S2A-Lab/CAD-Binder-Jetting-3D-Printer/X Axis/Encoder Rail/A_XA_ER.SLDASM

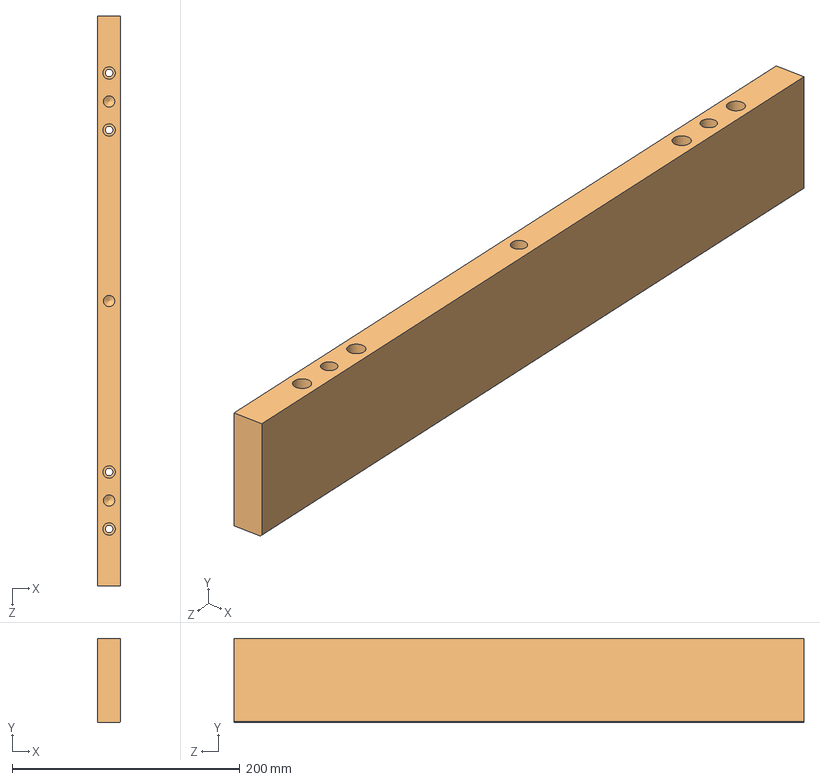
[picture p1: CAD file, 2025-05-02]
X Axis/Encoder Rail/A_XA_ER.SLDASM
20.2 x 74.0 x 500.0 mm
PE_XA_ER_BF003_scale_block
PE_XA_ER_encoder_strip-A_9420_0048
