S2A-Lab/CAD-Binder-Jetting-3D-Printer/Gantry/Hopper/SG4L TM.SLDASM

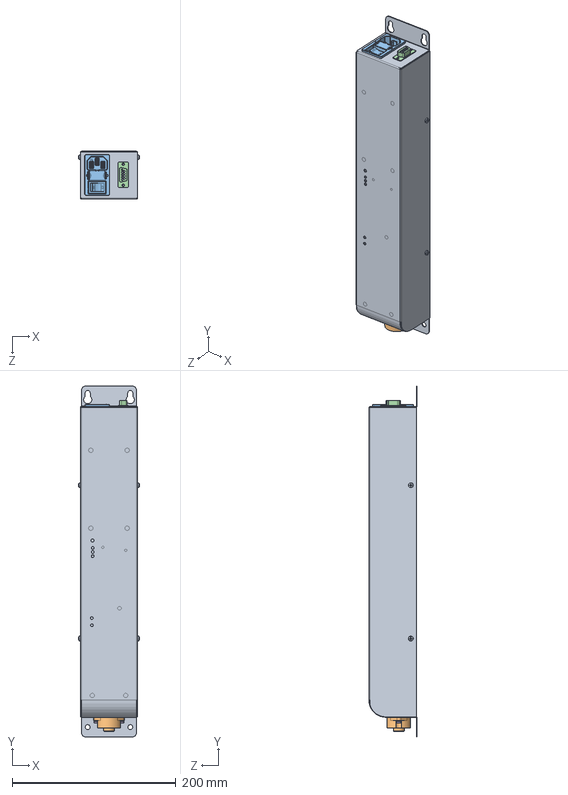
[picture p2: CAD file, 2025-05-02]
Gantry/Hopper/SG4L TM.SLDASM
74.7 x 429.0 x 59.0 mm
888016919_01^SG4L TM(2)_SG4L TM
370843000^SG4L TM(2)_SG4L TM
350200000_01^SG4L TM(2)_SG4L TM
371806910^SG4L TM(2)_SG4L TM
Federring rostfrei_M 3^SG4L TM(2)_SG4L TM x 2
Linsenschr. rostf. TORX_M3 x 8^SG4L TM(2)_SG4L TM x 2
