S2A-Lab/CAD-Binder-Jetting-3D-Printer/Gantry/Recoating System/Fine Roller/pcb/printedcircuit.SLDASM

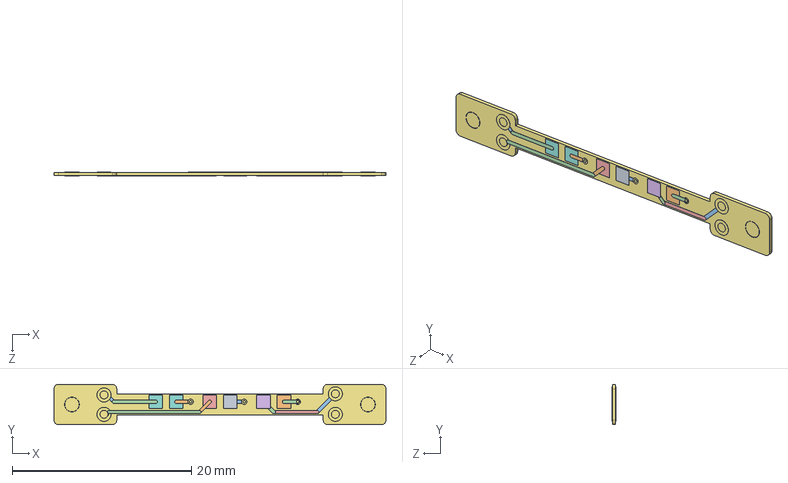
[picture p3: CAD file, 2025-05-02]
Gantry/Recoating System/Fine Roller/pcb/printedcircuit.SLDASM
37.0 x 4.50 x 0.391 mm
Via Hole-Part-1 x 2
Track (220mil,520mil)(232.718mil,520mil) on Top Layer-Part-1
Track (232.718mil,520mil)(262.718mil,490mil) on Top Layer-Part-1
Track (262.718mil,490mil)(447.402mil,490mil) on Top Layer-Part-1
Via Hole-Part-1-1 x 4
Via Bottom Layer-Part-1 x 4
Via Top Layer-Part-1 x 4
Pad Fs3-0(447.402mil,490mil) on Top Layer-Part-1
Track (220mil,435mil)(232.718mil,435mil) on Top Layer-Part-1
Track (638.602mil,445mil)(683.602mil,490mil) on Top Layer-Part-1
Track (232.718mil,435mil)(242.718mil,445mil) on Top Layer-Part-1
Track (242.718mil,445mil)(638.602mil,445mil) on Top Layer-Part-1
Pad Fs2-0(683.602mil,490mil) on Top Layer-Part-1
Track (600mil,490mil)(835mil,490mil) on Bottom Layer-Part-1
Track (835mil,490mil)(1070mil,490mil) on Bottom Layer-Part-1
Track (1180mil,490mil)(1235mil,435mil) on Bottom Layer-Part-1
Track (1070mil,490mil)(1180mil,490mil) on Bottom Layer-Part-1
Track (537.402mil,490mil)(600mil,490mil) on Top Layer-Part-1
Track (773.602mil,490mil)(835mil,490mil) on Top Layer-Part-1
Track (1009.842mil,490mil)(1070mil,490mil) on Top Layer-Part-1
Via Hole-Part-1-2 x 3
Via Bottom Layer-Part-1-1 x 3
Via Top Layer-Part-1-1 x 3
Pad Fs3-1(537.402mil,490mil) on Top Layer-Part-1
Pad Fs2-1(773.602mil,490mil) on Top Layer-Part-1
Pad Fs1-1(1009.842mil,490mil) on Top Layer-Part-1
Track (1155mil,445mil)(1235mil,525mil) on Top Layer-Part-1
Track (919.842mil,490mil)(964.842mil,445mil) on Top Layer-Part-1
Track (964.842mil,445mil)(1155mil,445mil) on Top Layer-Part-1
Pad Fs1-0(919.842mil,490mil) on Top Layer-Part-1
Board-Part-1
