S2A-Lab/CAD-Binder-Jetting-3D-Printer/Gantry/Recoating System/Fine Roller/pcb/Board.sldasm

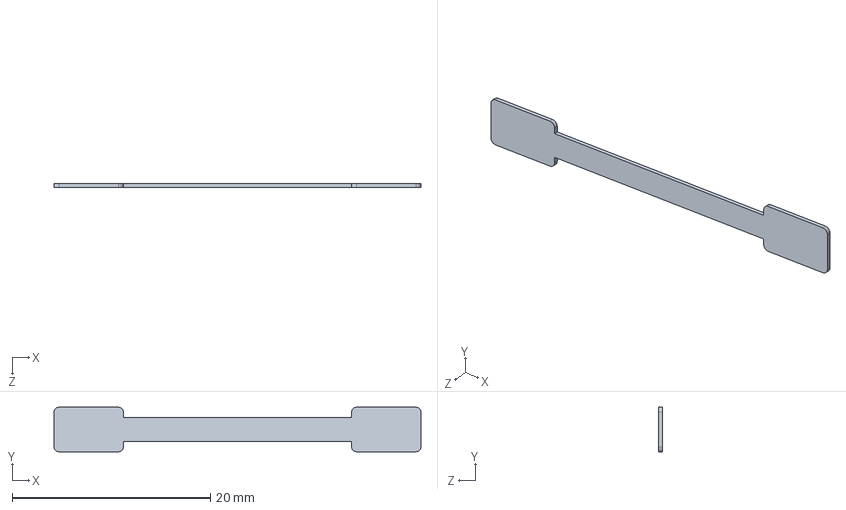
[picture p4: CAD file, 2025-05-02]
Gantry/Recoating System/Fine Roller/pcb/Board.sldasm
37.0 x 4.50 x 0.371 mm
