S2A-Lab/CAD-Binder-Jetting-3D-Printer/Gantry/Hopper/PE_G_H_SK3510 Hummel 90.SLDPRT

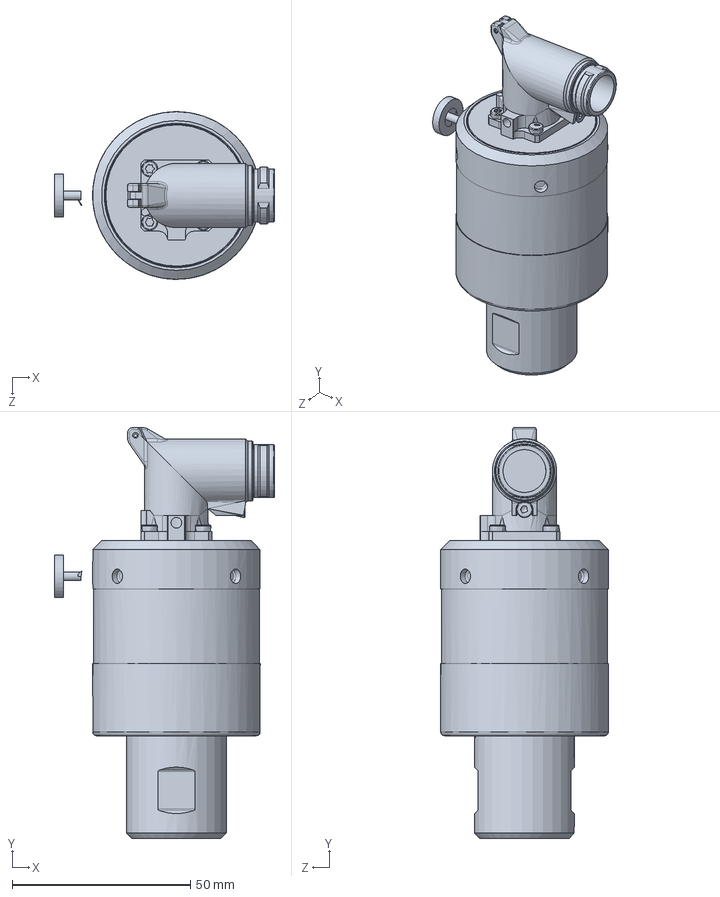
[picture p5: CAD file, 2025-05-02]
Gantry/Hopper/PE_G_H_SK3510 Hummel 90.SLDPRT
61.7 x 115.2 x 47.0 mm
