S2A-Lab/CAD-Binder-Jetting-3D-Printer/Gantry/P_G_C.SLDPRT

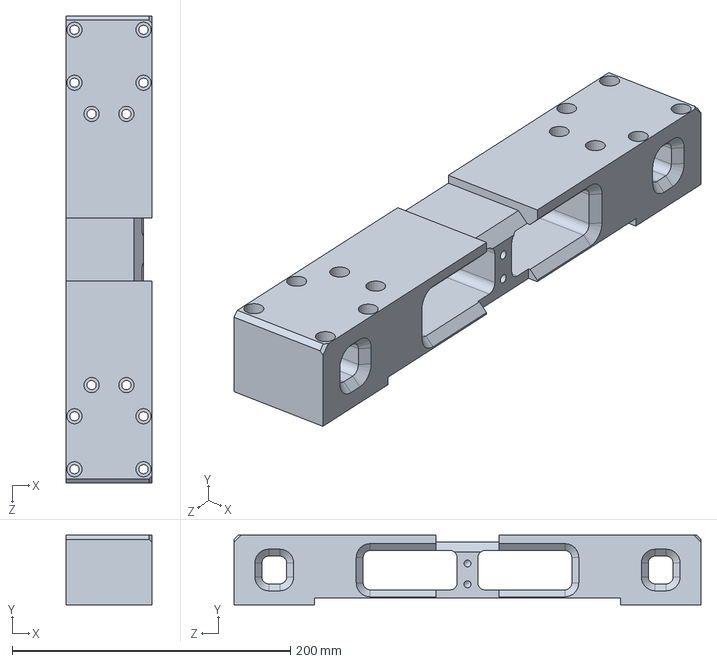
[picture p6: CAD file, 2025-05-02]
Gantry/P_G_C.SLDPRT
61.7 x 50.0 x 335.8 mm
