S2A-Lab/CAD-Binder-Jetting-3D-Printer/Gantry/Print Head Motion System/PE_G_PHM_HSB.SLDPRT

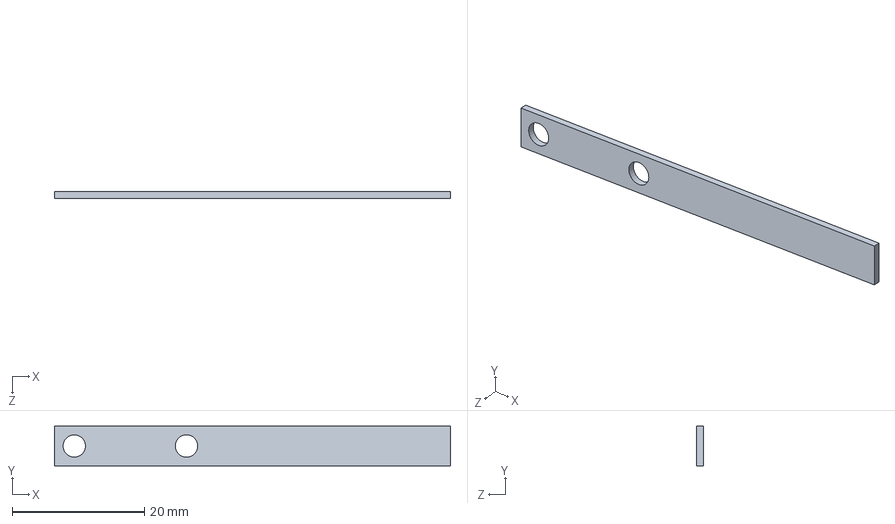
[picture p7: CAD file, 2025-05-02]
Gantry/Print Head Motion System/PE_G_PHM_HSB.SLDPRT
60.0 x 6.00 x 1.00 mm
