S2A-Lab/CAD-Binder-Jetting-3D-Printer/Gantry/Recoating System/Fine Roller/force_measuring_roller.beam_mount.SLDPRT

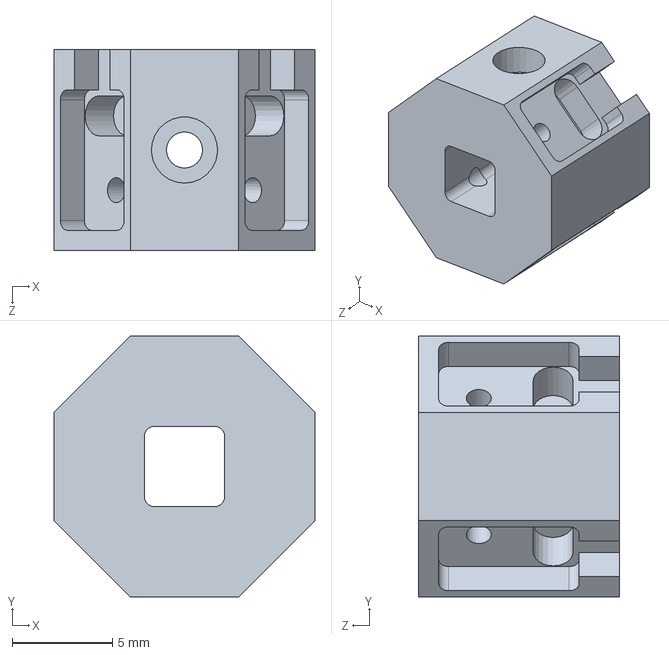
[picture p8: CAD file, 2025-05-02]
Gantry/Recoating System/Fine Roller/force_measuring_roller.beam_mount.SLDPRT
13.0 x 13.0 x 10.0 mm
