S2A-Lab/CAD-Binder-Jetting-3D-Printer/Gantry/Recoating System/Fine Roller/pcb.force_sensor/pcb_layout.SLDPRT

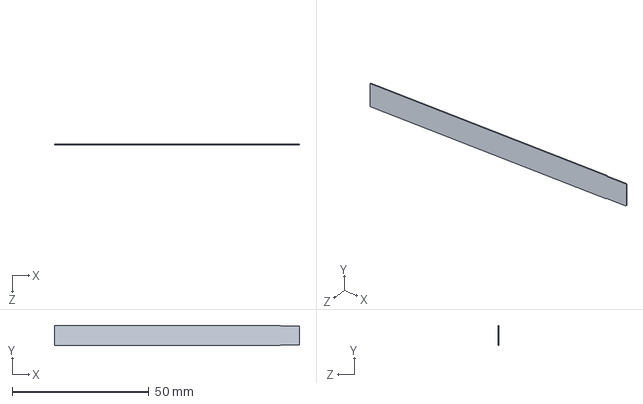
[picture p9: CAD file, 2025-05-02]
Gantry/Recoating System/Fine Roller/pcb.force_sensor/pcb_layout.SLDPRT
89.5 x 7.33 x 0.3 mm
