S2A-Lab/CAD-Binder-Jetting-3D-Printer/Gantry/Recoating System/PE_P_G_R_CR_6661K14_Ball Bearing.SLDPRT

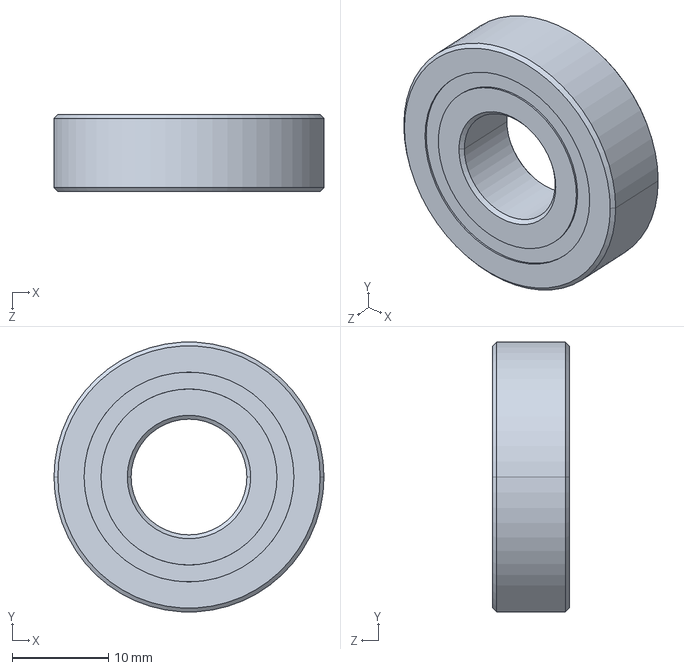
[picture p10: CAD file, 2025-05-02]
Gantry/Recoating System/PE_P_G_R_CR_6661K14_Ball Bearing.SLDPRT
28.0 x 28.0 x 8.00 mm
