S2A-Lab/CAD-Binder-Jetting-3D-Printer/PE_HFSH8-8080-500.sldprt

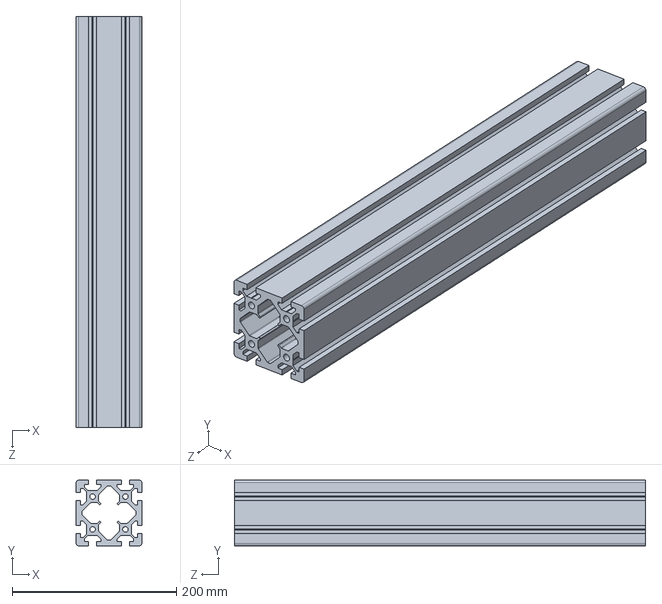
[picture p11: CAD file, 2025-05-02]
PE_HFSH8-8080-500.sldprt
80.0 x 80.0 x 500.0 mm
