S2A-Lab/CAD-Binder-Jetting-3D-Printer/Vent Hood/P_VH_HA_F.SLDPRT

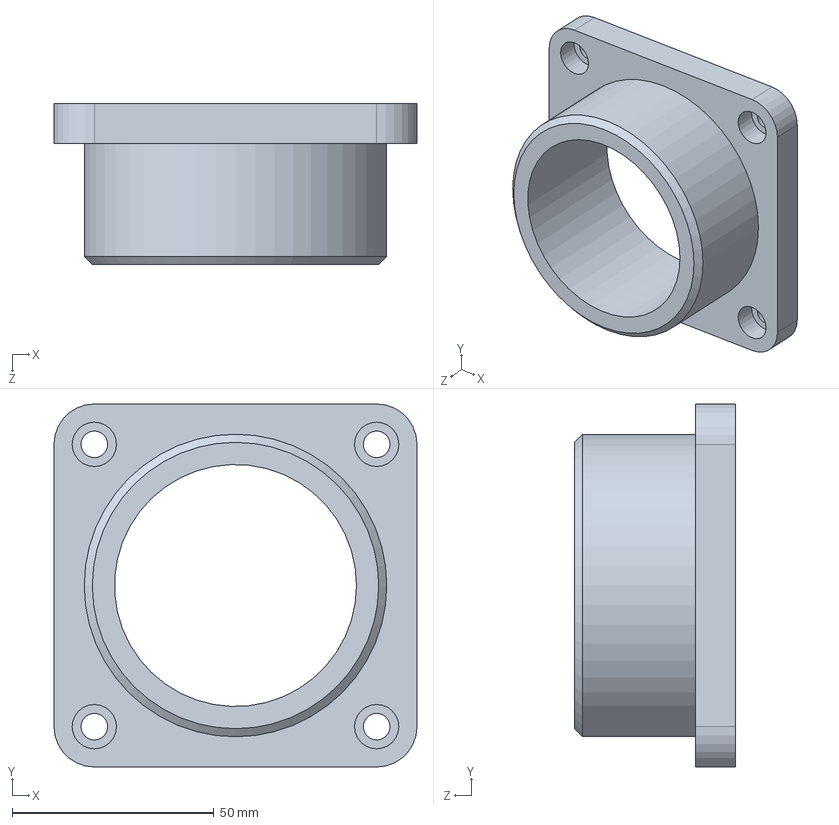
[picture p12: CAD file, 2025-05-02]
Vent Hood/P_VH_HA_F.SLDPRT
90.0 x 90.0 x 40.0 mm
