S2A-Lab/CAD-Binder-Jetting-3D-Printer/Gantry/Hopper/P_G_H_MT.SLDPRT

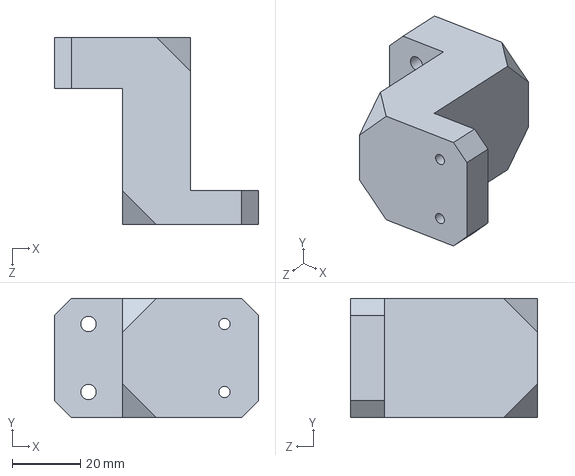
[picture p13: CAD file, 2025-05-02]
Gantry/Hopper/P_G_H_MT.SLDPRT
60.0 x 35.0 x 55.0 mm
