S2A-Lab/CAD-Binder-Jetting-3D-Printer/Gantry/P_G_F.SLDPRT

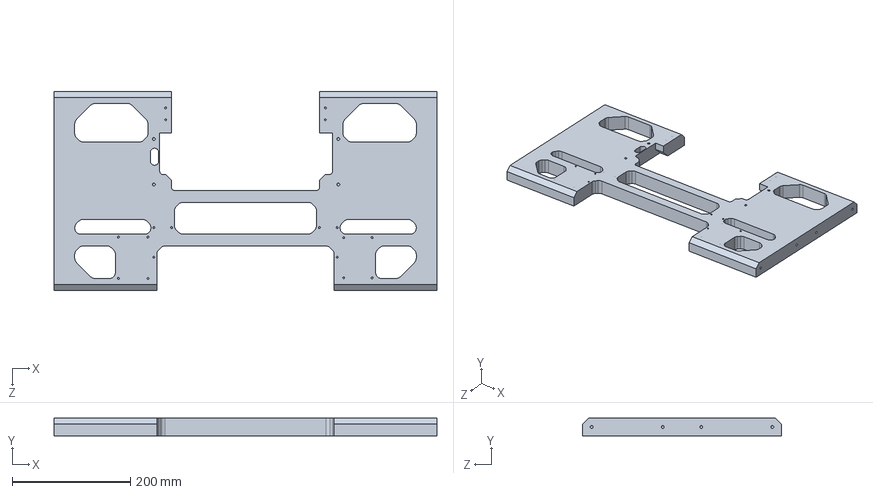
[picture p14: CAD file, 2025-05-02]
Gantry/P_G_F.SLDPRT
647.6 x 30.0 x 335.8 mm
