S2A-Lab/CAD-Binder-Jetting-3D-Printer/Gantry/Print Head Motion System/PE_G_PHM_AEB_A.SLDPRT

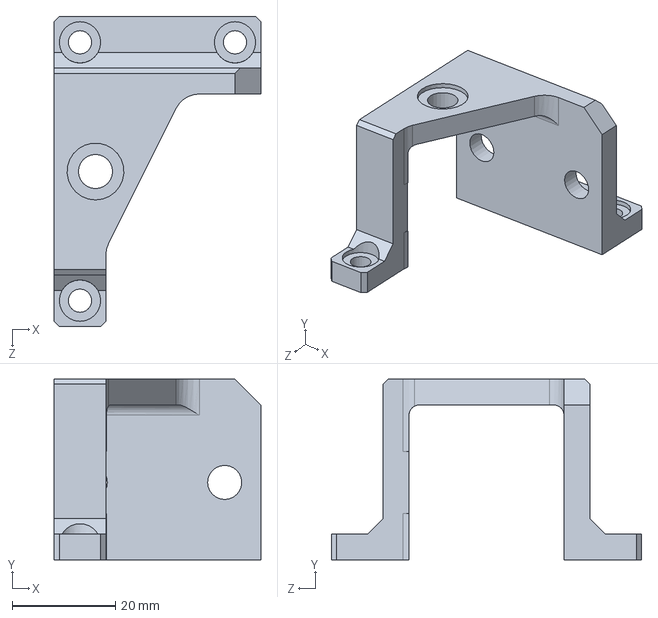
[picture p15: CAD file, 2025-05-02]
Gantry/Print Head Motion System/PE_G_PHM_AEB_A.SLDPRT
40.0 x 35.0 x 60.0 mm
