S2A-Lab/CAD-Binder-Jetting-3D-Printer/Gantry/Recoating System/Fine Roller/P_G_R_FR_FMU_SF.SLDPRT

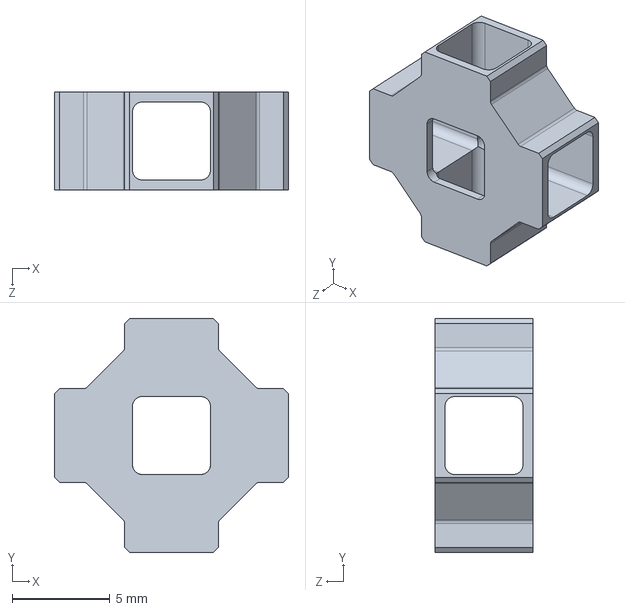
[picture p16: CAD file, 2025-05-02]
Gantry/Recoating System/Fine Roller/P_G_R_FR_FMU_SF.SLDPRT
12.0 x 12.0 x 5.00 mm
