S2A-Lab/CAD-Binder-Jetting-3D-Printer/Gantry/Recoating System/P_G_R_MP.SLDPRT

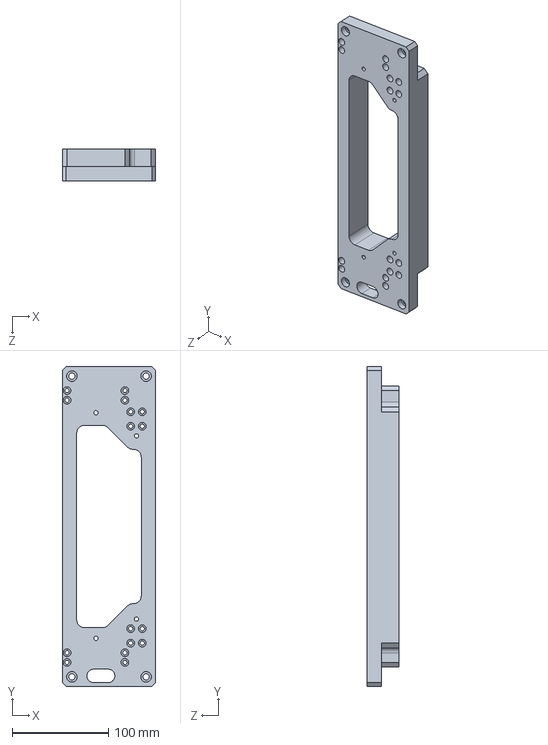
[picture p17: CAD file, 2025-05-02]
Gantry/Recoating System/P_G_R_MP.SLDPRT
97.0 x 332.0 x 33.0 mm
