S2A-Lab/CAD-Binder-Jetting-3D-Printer/PE_HFSH8-8080-140.SLDPRT

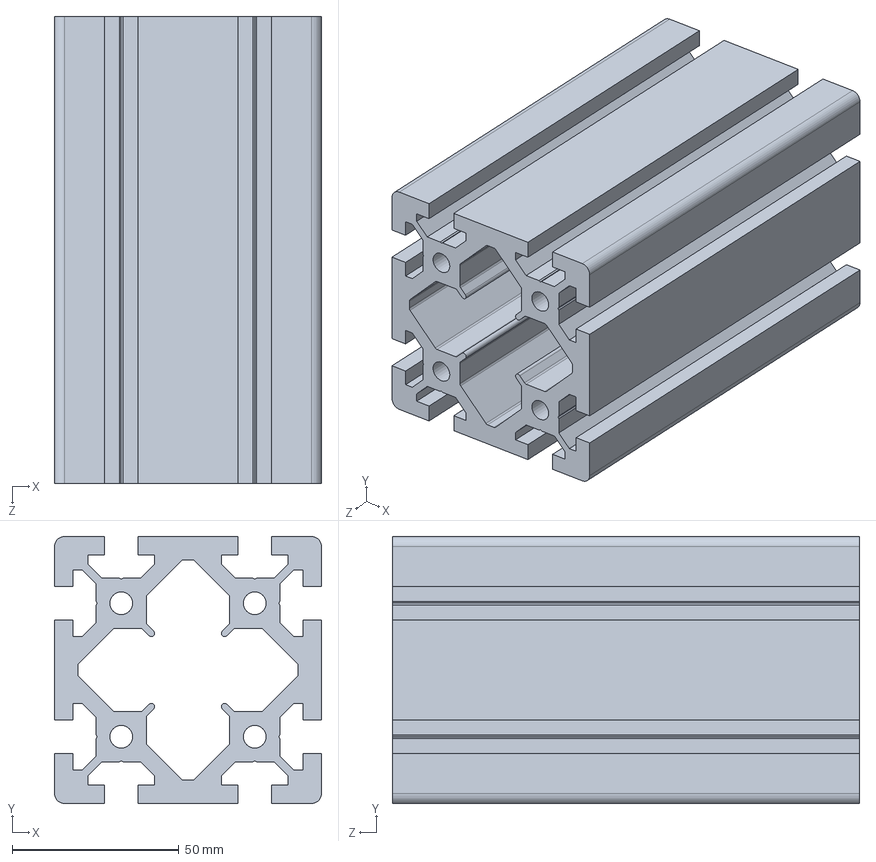
[picture p18: CAD file, 2025-05-02]
PE_HFSH8-8080-140.SLDPRT
80.0 x 80.0 x 140.0 mm
