S2A-Lab/CAD-Binder-Jetting-3D-Printer/Vent Hood/P_VH_HA_B.SLDPRT

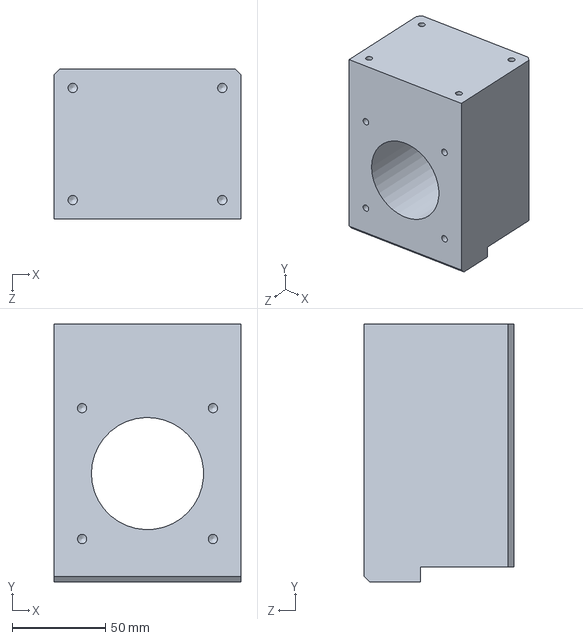
[picture p19: CAD file, 2025-05-02]
Vent Hood/P_VH_HA_B.SLDPRT
100.0 x 138.0 x 80.0 mm
