S2A-Lab/CAD-Binder-Jetting-3D-Printer/X Axis/Rail/PE_XA_R_SFU25_742.SLDPRT

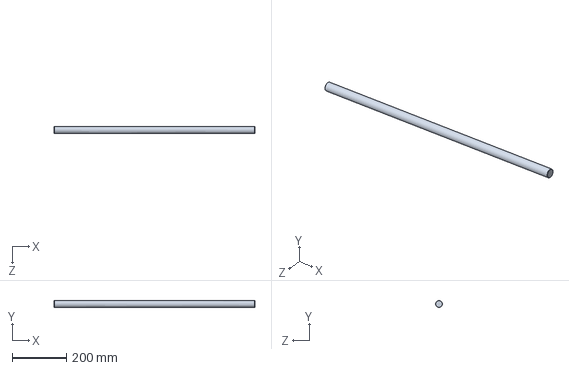
[picture p20: CAD file, 2025-05-02]
X Axis/Rail/PE_XA_R_SFU25_742.SLDPRT
742.0 x 25.0 x 25.0 mm
