S2A-Lab/CAD-Binder-Jetting-3D-Printer/Gantry/Hopper/P_G_H_HADP.SLDPRT

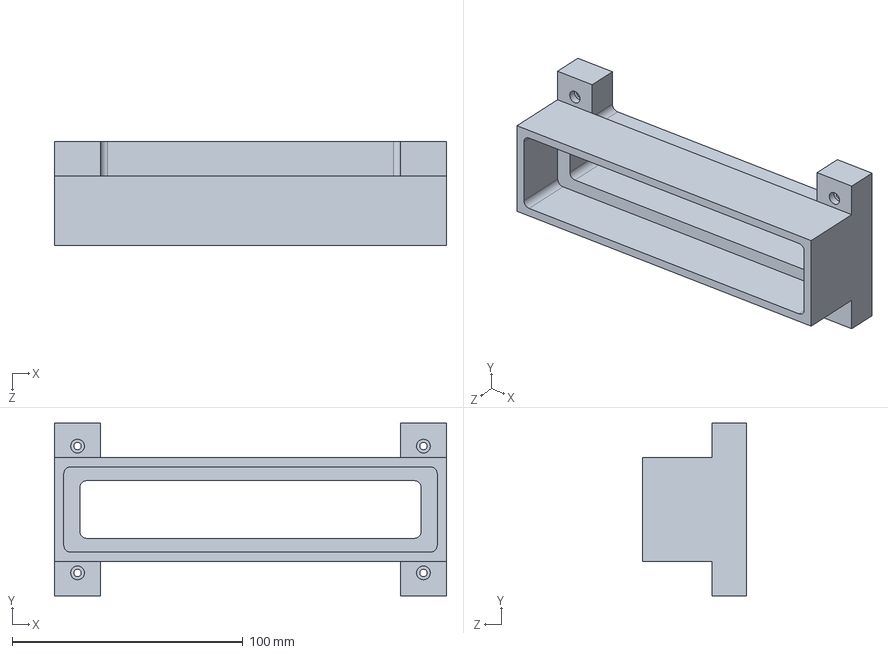
[picture p21: CAD file, 2025-05-02]
Gantry/Hopper/P_G_H_HADP.SLDPRT
170.0 x 75.0 x 45.0 mm
