S2A-Lab/CAD-Binder-Jetting-3D-Printer/Gantry/P_G_CEM.SLDPRT

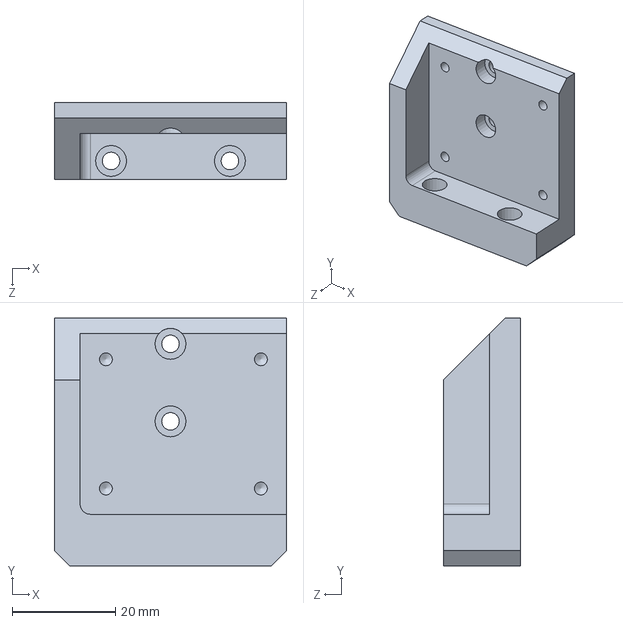
[picture p22: CAD file, 2025-05-02]
Gantry/P_G_CEM.SLDPRT
45.0 x 48.0 x 15.0 mm
