S2A-Lab/CAD-Binder-Jetting-3D-Printer/Gantry/Print Head Motion System/PE_G_PHM_MGN12C1R265Z0HM_carriage.SLDPRT

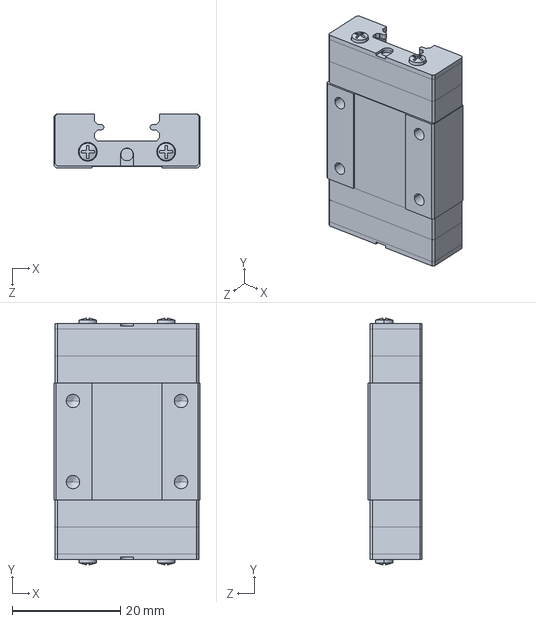
[picture p23: CAD file, 2025-05-02]
Gantry/Print Head Motion System/PE_G_PHM_MGN12C1R265Z0HM_carriage.SLDPRT
27.0 x 45.7 x 10.0 mm
