S2A-Lab/CAD-Binder-Jetting-3D-Printer/Gantry/Recoating System/P_G_R_CR_ADJBR.SLDPRT

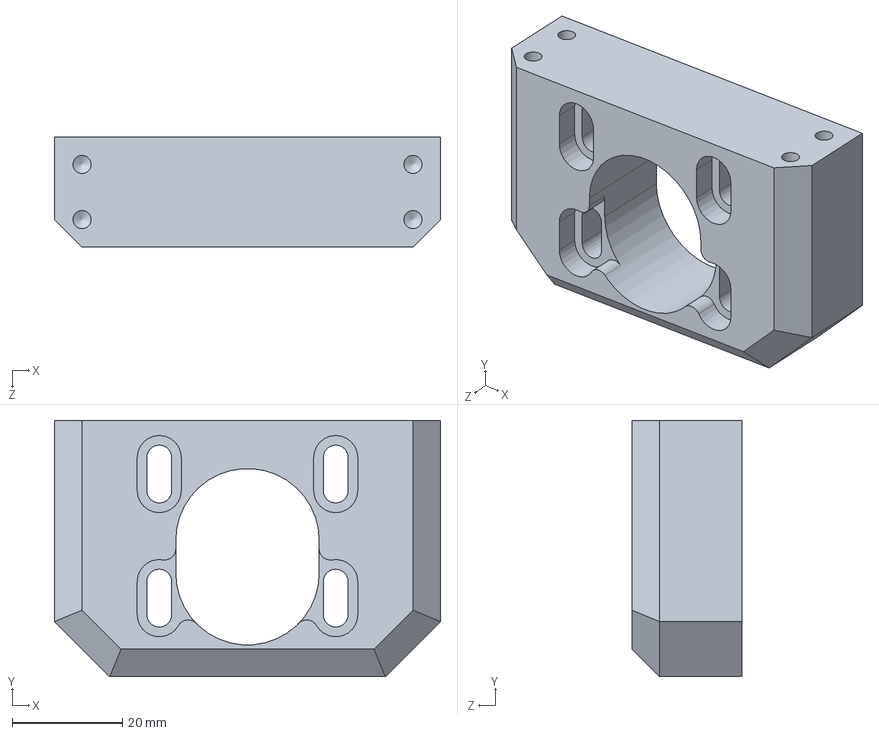
[picture p25: CAD file, 2025-05-02]
Gantry/Recoating System/P_G_R_CR_ADJBR.SLDPRT
70.0 x 46.5 x 20.0 mm
