S2A-Lab/CAD-Binder-Jetting-3D-Printer/PE_GFS8-4080-640.SLDPRT

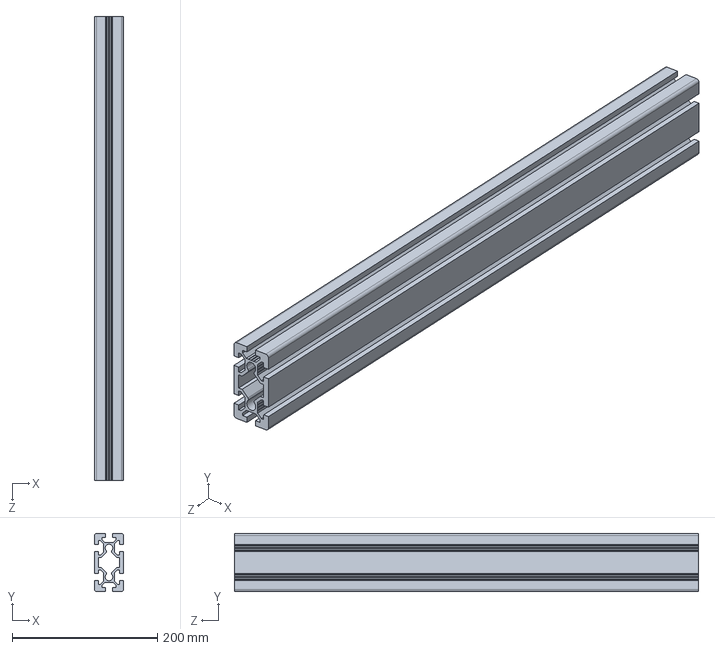
[picture p26: CAD file, 2025-05-02]
PE_GFS8-4080-640.SLDPRT
40.0 x 80.0 x 640.0 mm
