S2A-Lab/CAD-Binder-Jetting-3D-Printer/Vent Hood/vent_hood_job-box_wall-top-flange.SLDPRT

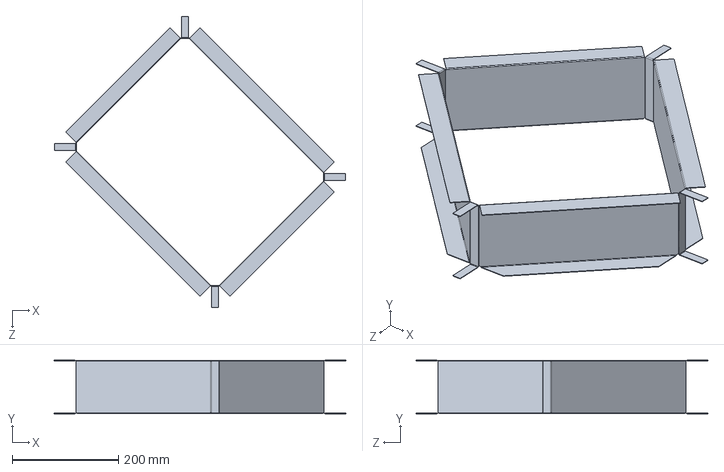
[picture p27: CAD file, 2025-05-02]
Vent Hood/vent_hood_job-box_wall-top-flange.SLDPRT
547.3 x 100.2 x 547.3 mm
