S2A-Lab/CAD-Binder-Jetting-3D-Printer/X Axis/Encoder Rail/PE_XA_ER_encoder_strip-A_9420_0048.SLDPRT

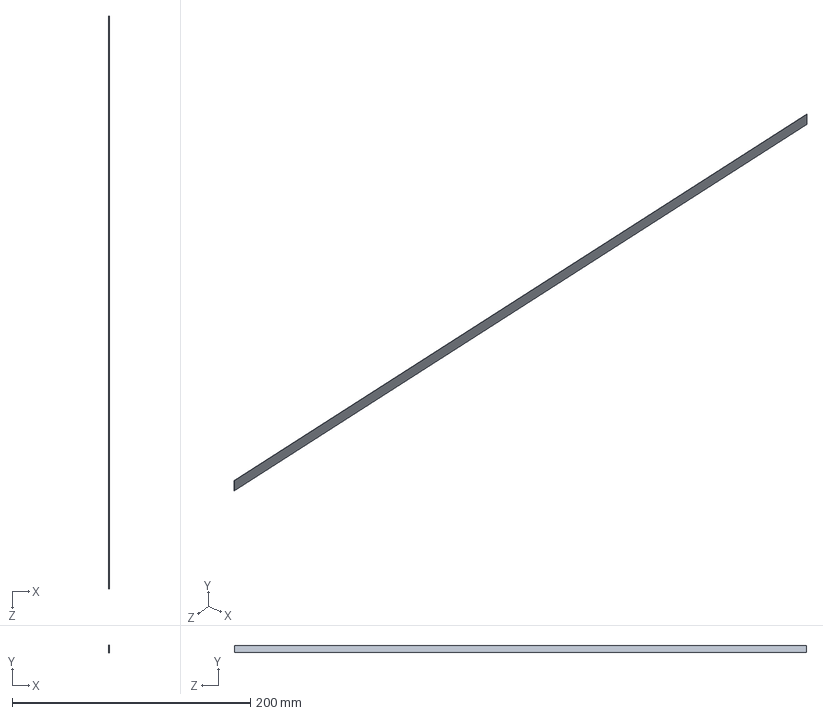
[picture p28: CAD file, 2025-05-02]
X Axis/Encoder Rail/PE_XA_ER_encoder_strip-A_9420_0048.SLDPRT
0.2 x 6.00 x 480.0 mm
