S2A-Lab/CAD-Binder-Jetting-3D-Printer/Gantry/Hopper/P_G_H_SM.SLDPRT

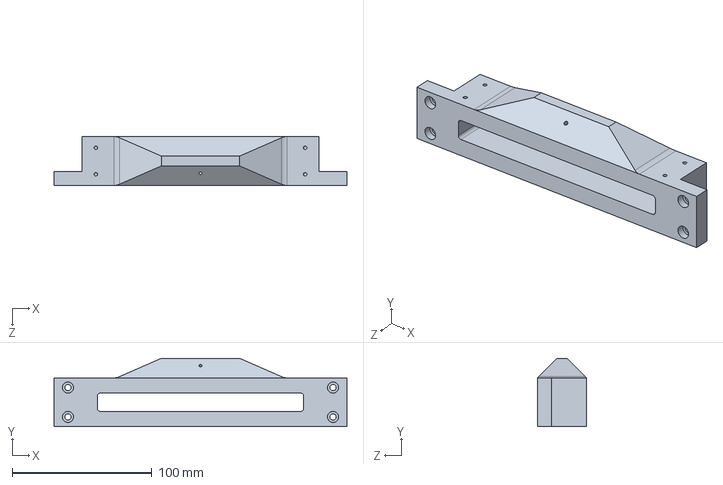
[picture p29: CAD file, 2025-05-02]
Gantry/Hopper/P_G_H_SM.SLDPRT
210.0 x 49.0 x 35.0 mm
