S2A-Lab/CAD-Binder-Jetting-3D-Printer/Gantry/P_G_FILLET.SLDPRT

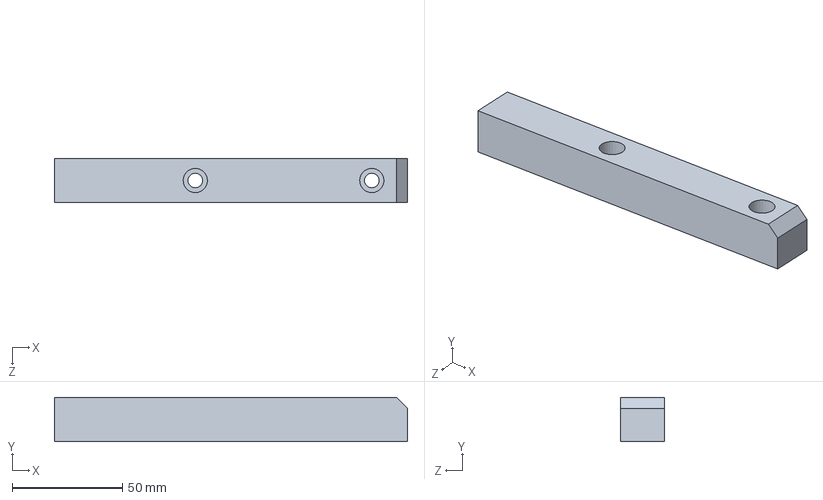
[picture p30: CAD file, 2025-05-02]
Gantry/P_G_FILLET.SLDPRT
160.0 x 20.0 x 20.0 mm
