S2A-Lab/CAD-Binder-Jetting-3D-Printer/Gantry/Recoating System/Fine Roller/P_G_R_FR_MM.SLDPRT

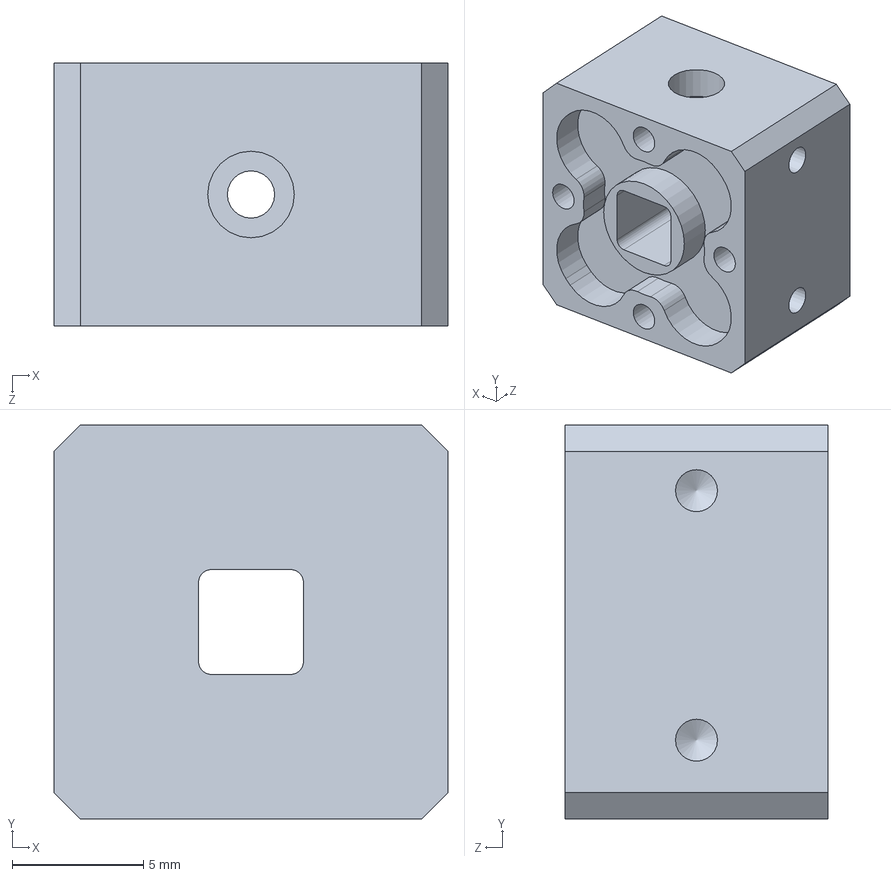
[picture p31: CAD file, 2025-05-02]
Gantry/Recoating System/Fine Roller/P_G_R_FR_MM.SLDPRT
15.0 x 15.0 x 10.0 mm
