S2A-Lab/CAD-Binder-Jetting-3D-Printer/Gantry/Recoating System/P_G_R_FR_ADJBR.SLDPRT

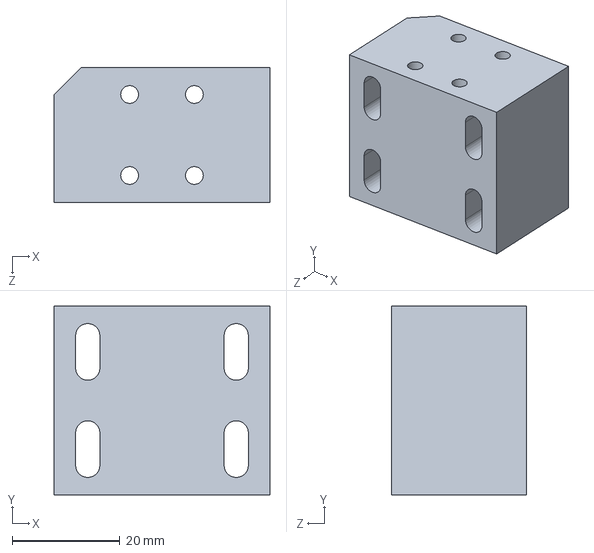
[picture p32: CAD file, 2025-05-02]
Gantry/Recoating System/P_G_R_FR_ADJBR.SLDPRT
40.0 x 35.0 x 25.0 mm
