S2A-Lab/CAD-Binder-Jetting-3D-Printer/X Axis/Carriage/PE_XA_C_S250Q_HAforcer.SLDPRT

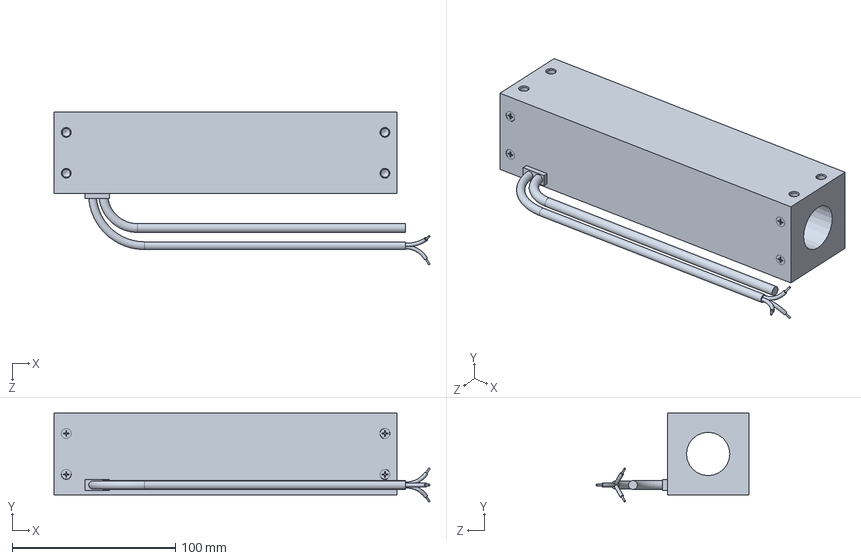
[picture p34: CAD file, 2025-05-02]
X Axis/Carriage/PE_XA_C_S250Q_HAforcer.SLDPRT
230.1 x 54.3 x 93.6 mm
