S2A-Lab/CAD-Binder-Jetting-3D-Printer/Z Axis/P_ZA_G_P_B.SLDPRT

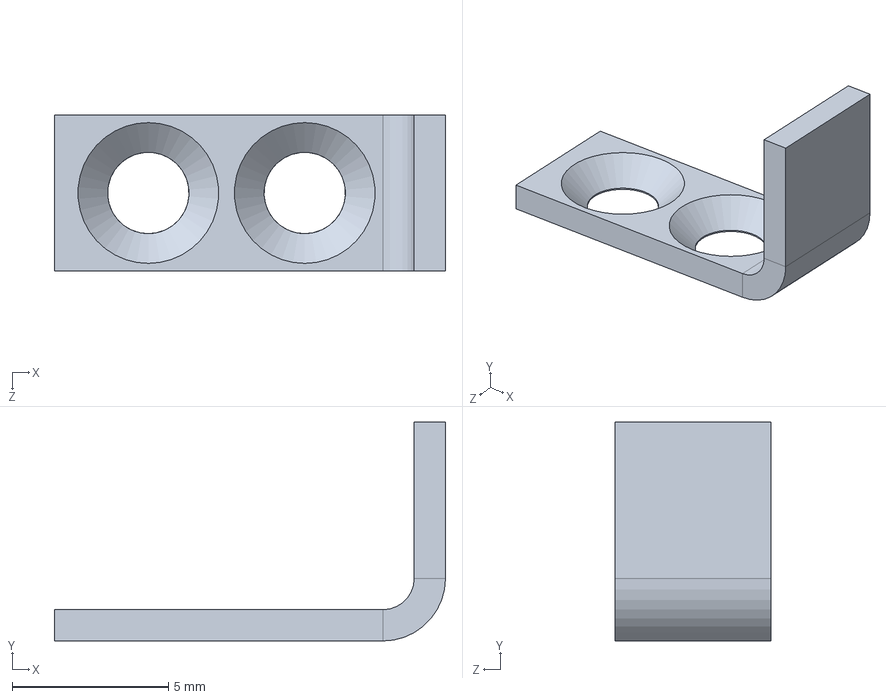
[picture p35: CAD file, 2025-05-02]
Z Axis/P_ZA_G_P_B.SLDPRT
12.5 x 7.00 x 5.00 mm
