S2A-Lab/CAD-Binder-Jetting-3D-Printer/Gantry/P_G_CP.SLDPRT

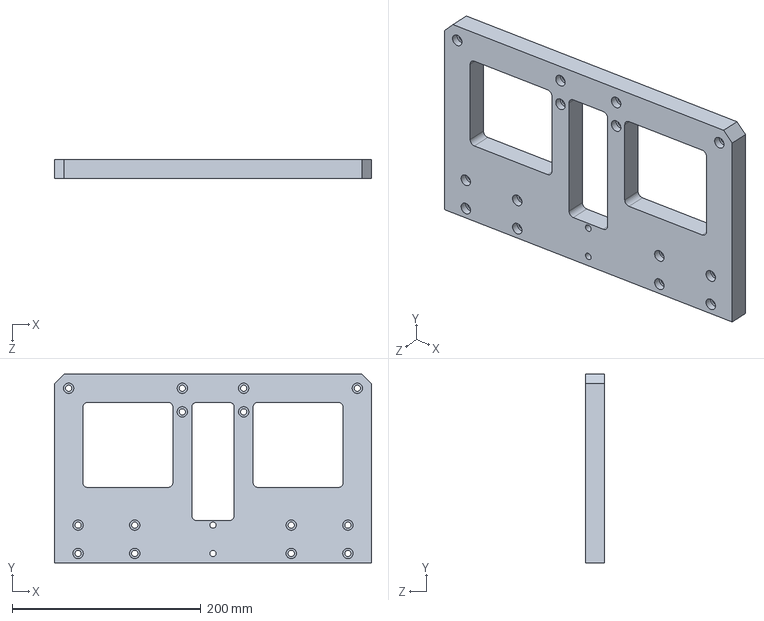
[picture p36: CAD file, 2025-05-02]
Gantry/P_G_CP.SLDPRT
335.8 x 200.0 x 20.0 mm
