S2A-Lab/CAD-Binder-Jetting-3D-Printer/Gantry/Print Head Motion System/PE_G_PHM_MGN12C1R300Z0HM_EL_rail.SLDPRT

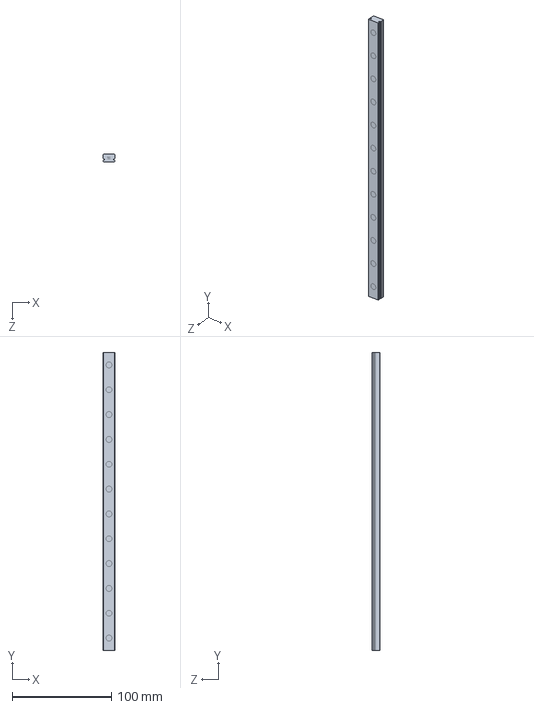
[picture p37: CAD file, 2025-05-02]
Gantry/Print Head Motion System/PE_G_PHM_MGN12C1R300Z0HM_EL_rail.SLDPRT
12.0 x 300.0 x 8.00 mm
