S2A-Lab/CAD-Binder-Jetting-3D-Printer/Gantry/Recoating System/Fine Roller/PE_G_R_FR_FMU_6656K86_Ultra-Thin Ball Bearing.SLDPRT

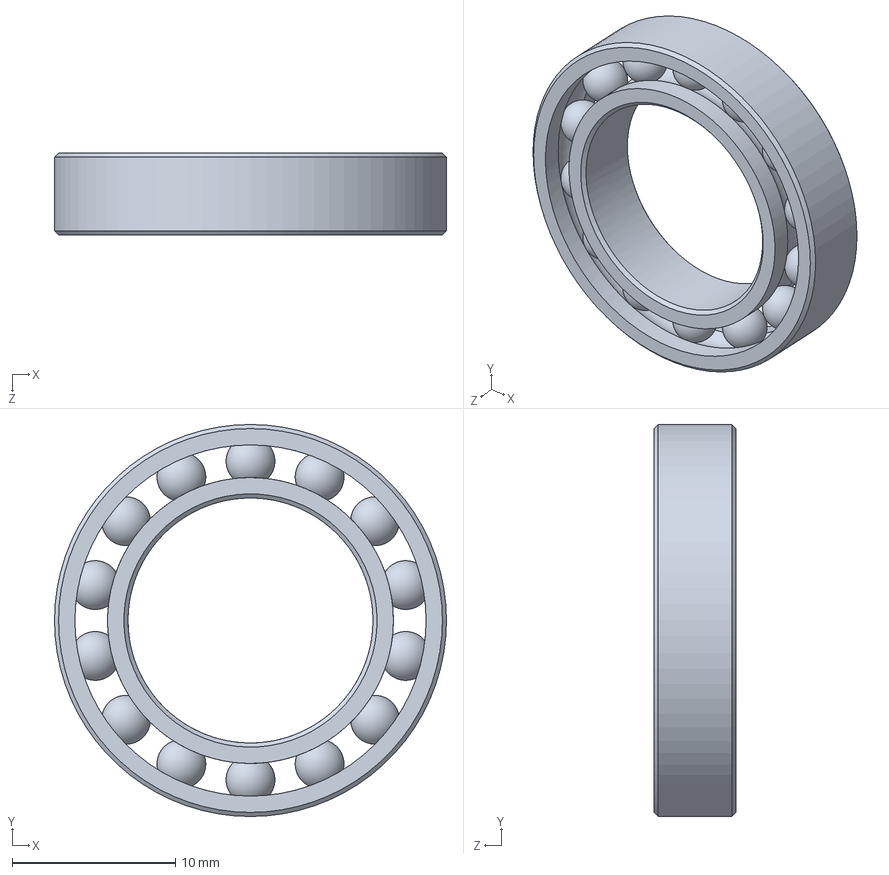
[picture p38: CAD file, 2025-05-02]
Gantry/Recoating System/Fine Roller/PE_G_R_FR_FMU_6656K86_Ultra-Thin Ball Bearing.SLDPRT
24.0 x 24.0 x 5.00 mm
