S2A-Lab/CAD-Binder-Jetting-3D-Printer/Gantry/Recoating System/PE_P_G_R_CR_RoboMaster M2006 P36.SLDPRT

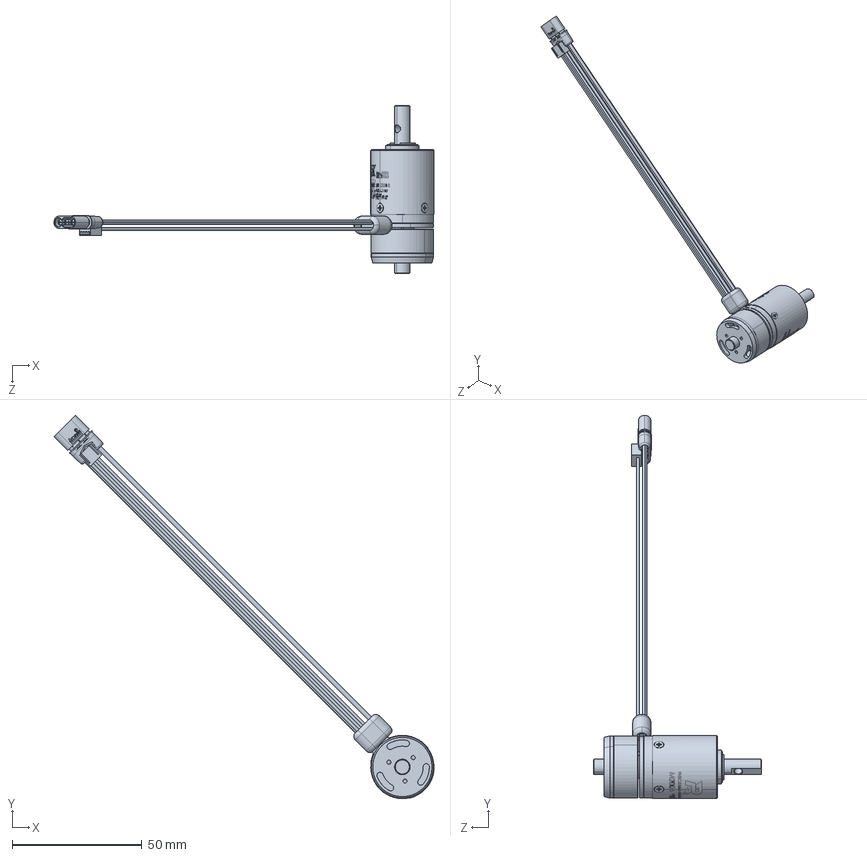
[picture p39: CAD file, 2025-05-02]
Gantry/Recoating System/PE_P_G_R_CR_RoboMaster M2006 P36.SLDPRT
146.5 x 147.7 x 64.8 mm
