S2A-Lab/CAD-Binder-Jetting-3D-Printer/P_TC.SLDPRT

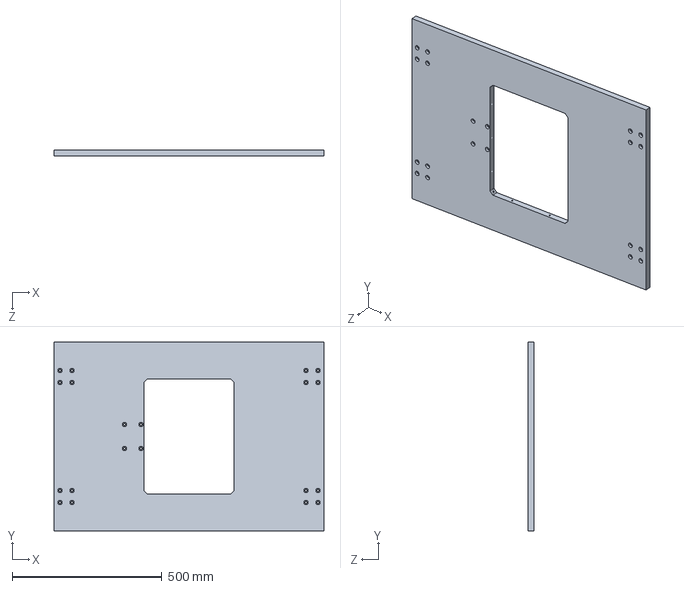
[picture p40: CAD file, 2025-05-02]
P_TC.SLDPRT
900.0 x 630.0 x 20.0 mm
