S2A-Lab/CAD-Binder-Jetting-3D-Printer/Vent Hood/PE_VH_FLEXIFLO_AIRSEEDER_HOSE_75MM.SLDPRT

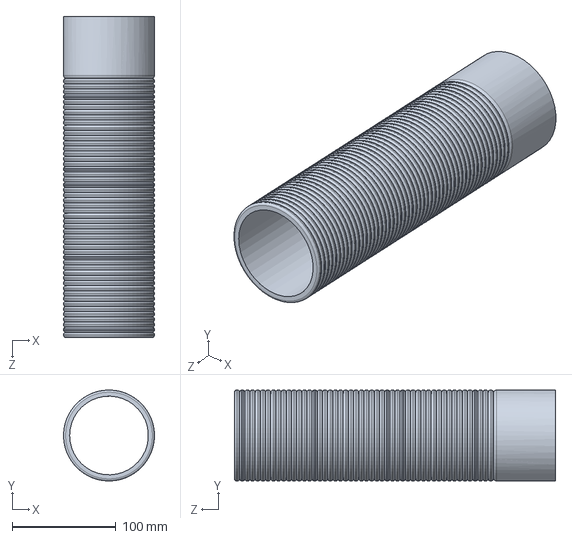
[picture p41: CAD file, 2025-05-02]
Vent Hood/PE_VH_FLEXIFLO_AIRSEEDER_HOSE_75MM.SLDPRT
87.8 x 87.8 x 310.0 mm
