S2A-Lab/CAD-Binder-Jetting-3D-Printer/Z Axis/P_ZA_JH_FRP.SLDPRT

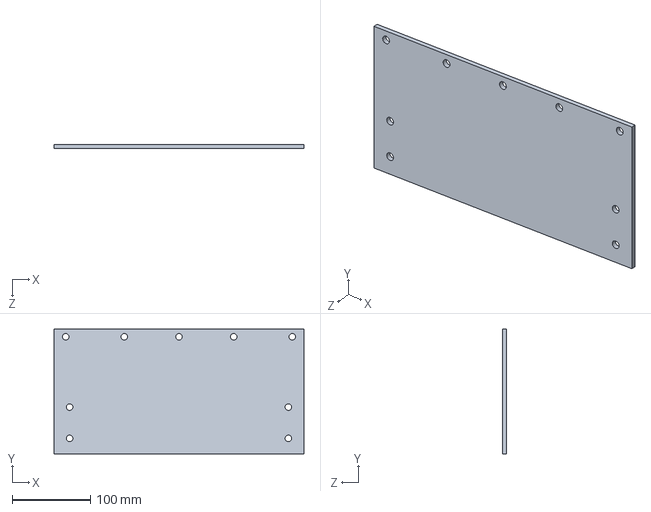
[picture p42: CAD file, 2025-05-02]
Z Axis/P_ZA_JH_FRP.SLDPRT
320.0 x 160.0 x 5.00 mm
