S2A-Lab/CAD-Binder-Jetting-3D-Printer/Gantry/Hopper/P_G_H_SC.SLDPRT

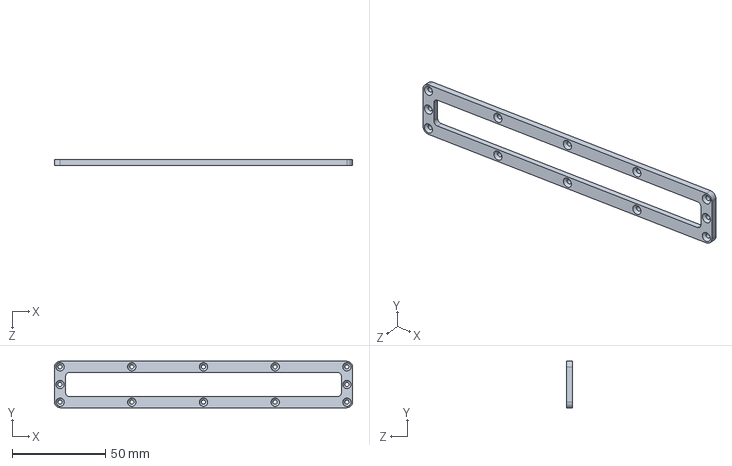
[picture p43: CAD file, 2025-05-02]
Gantry/Hopper/P_G_H_SC.SLDPRT
160.0 x 25.0 x 3.00 mm
