S2A-Lab/CAD-Binder-Jetting-3D-Printer/Gantry/Recoating System/Fine Roller/PE_G_R_FR_FMU_TFS.SLDPRT

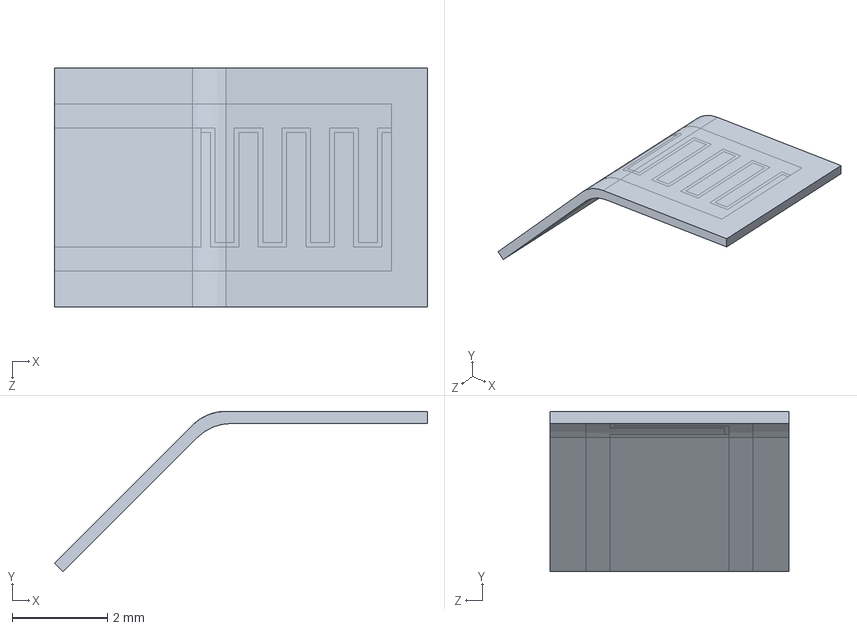
[picture p44: CAD file, 2025-05-02]
Gantry/Recoating System/Fine Roller/PE_G_R_FR_FMU_TFS.SLDPRT
7.82 x 3.36 x 5.00 mm
