S2A-Lab/CAD-Binder-Jetting-3D-Printer/P_BP.SLDPRT

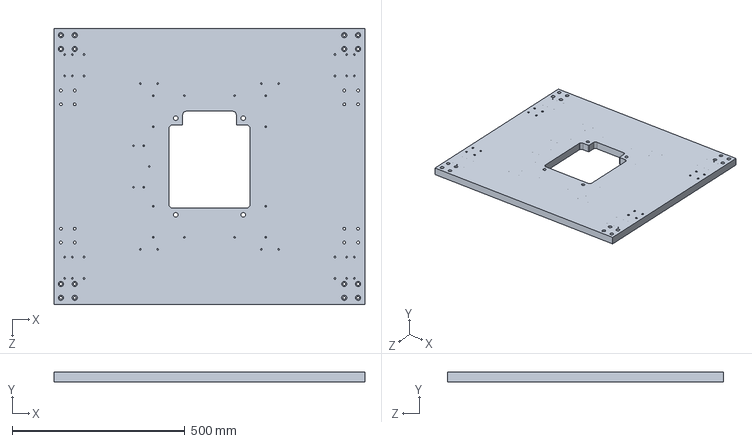
[picture p45: CAD file, 2025-05-02]
P_BP.SLDPRT
900.0 x 30.0 x 800.0 mm
