S2A-Lab/CAD-Binder-Jetting-3D-Printer/Vent Hood/P_VH_W.SLDPRT

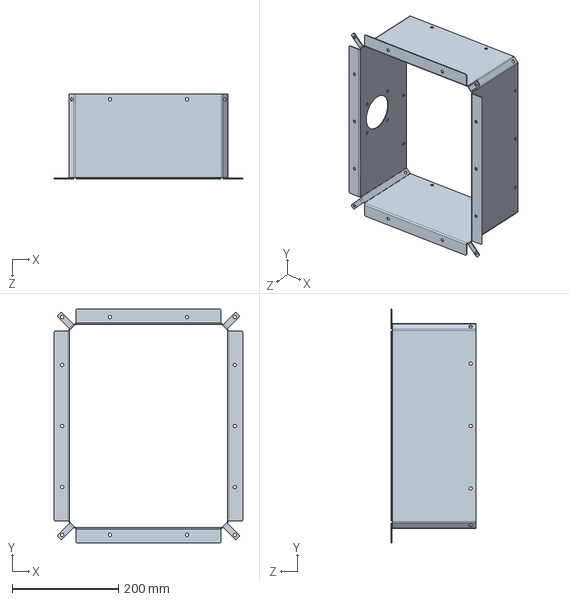
[picture p46: CAD file, 2025-05-02]
Vent Hood/P_VH_W.SLDPRT
355.5 x 440.5 x 160.0 mm
