S2A-Lab/CAD-Binder-Jetting-3D-Printer/X Axis/Carriage/A_XA_C.SLDASM

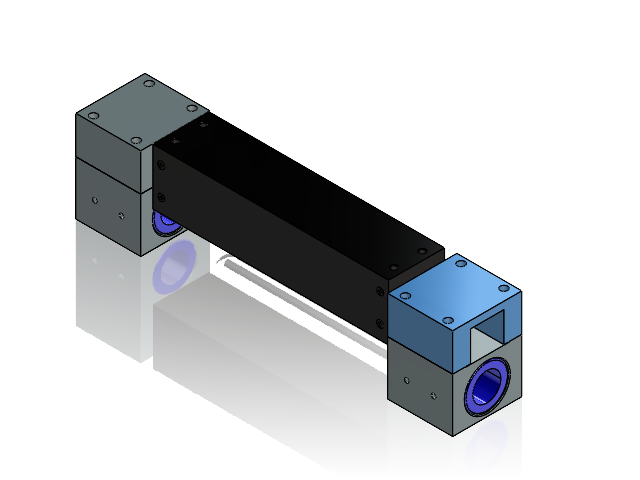
[picture p48: CAD file, 2025-05-02]
X Axis/Carriage/A_XA_C.SLDASM
PE_XA_C_S250Q_HAforcer
PE_XA_C_S8025P02 x 2
PE_XA_C_air_bushing_ID_25mm_solid_model_new_way_S302502_en x 2
PE_XA_C_MJELLS4_M5_B x 2
PE_XA_C_WT_006_Spacer x 2
