S2A-Lab/CAD-Binder-Jetting-3D-Printer/X Axis/Rail/AE_XA_R_P_MAKC1210M.SLDASM

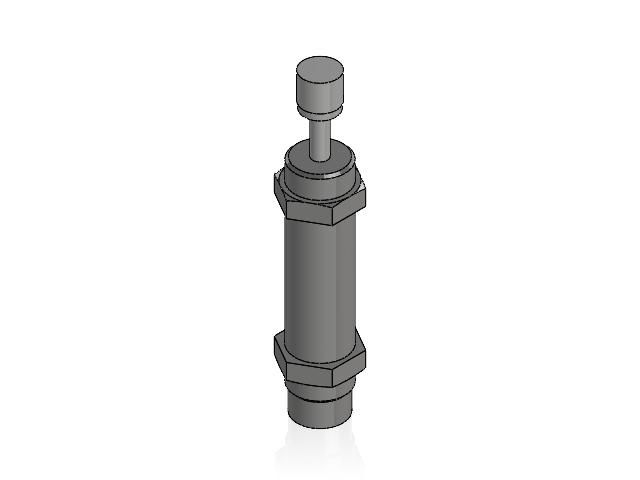
[picture p49: CAD file, 2025-05-02]
X Axis/Rail/AE_XA_R_P_MAKC1210M.SLDASM
[part, external] MAKC1210Mb
[part, external] MAKC1210Ar
[part, external] M12x1_0414N2 x 2
