S2A-Lab/CAD-Binder-Jetting-3D-Printer/Vent Hood/A_VH.SLDASM

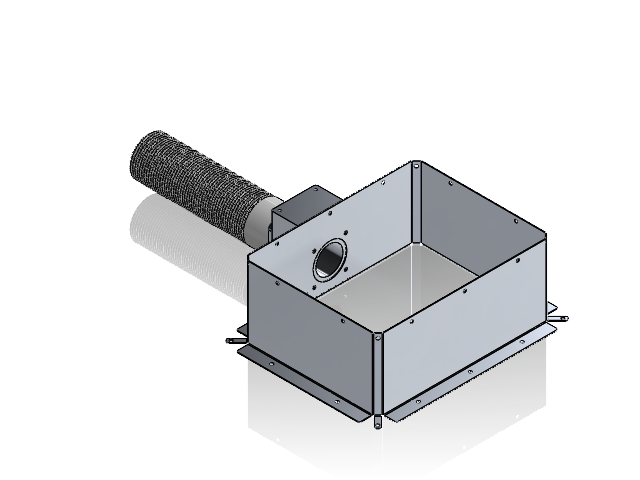
[picture p50: CAD file, 2025-05-02]
Vent Hood/A_VH.SLDASM
P_VH_W
PE_VH_FLEXIFLO_AIRSEEDER_HOSE_75MM
P_VH_HA_B
P_VH_HA_F
P_VH_HA_E
