S2A-Lab/CAD-Binder-Jetting-3D-Printer/X Axis/Rail/A_XA_R_P.SLDASM

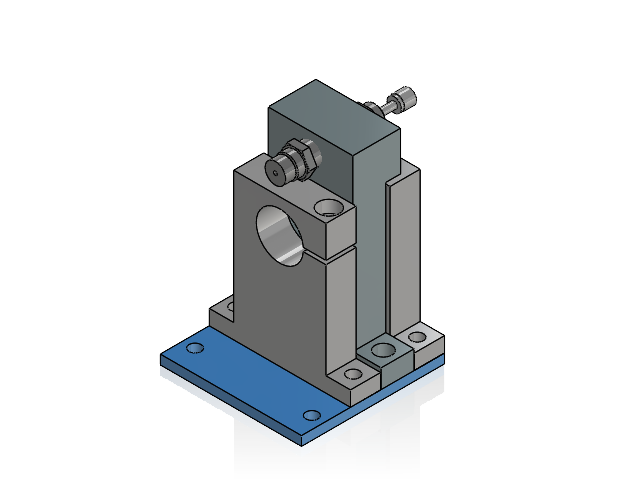
[picture p51: CAD file, 2025-05-02]
X Axis/Rail/A_XA_R_P.SLDASM
[part, external] MAKC1210Mb
[part, external] MAKC1210Ar
[part, external] M12x1_0414N2 x 2
PE_XA_R_P_SHWTM25_60_b_mod
PE_XA_R_P_BF_004_Bumper_Block
PE_XA_R_P_SHWTM25_60_b
PE_XA_R_P_BF_012_Spacer
