S2A-Lab/CAD-Binder-Jetting-3D-Printer/Gantry/Recoating System/A_G_R.SLDASM

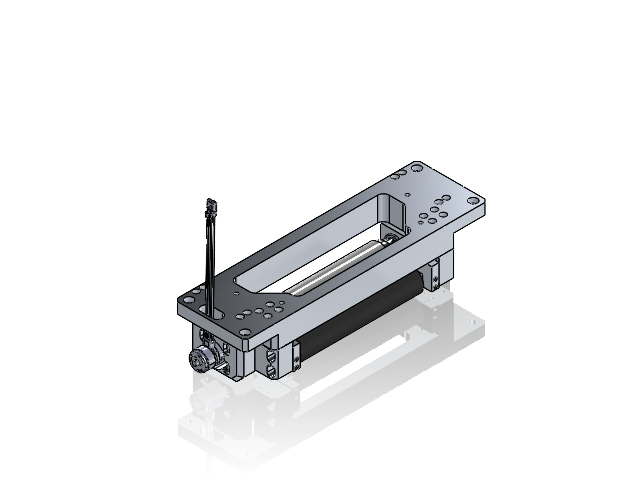
[picture p52: CAD file, 2025-05-02]
Gantry/Recoating System/A_G_R.SLDASM
P_G_R_CR
P_G_R_CR_F_A
P_G_R_CR_F_I
P_G_R_CR_F_MBR
P_G_R_CR_ADJBR x 2
P_G_R_CR_BBR
PE_P_G_R_CR_RoboMaster M2006 P36
PE_P_G_R_CR_6661K14_Ball Bearing
P_G_R_FR_ADPBR x 2
P_G_R_FR_ADJBR x 2
PE_G_R_FR_FMU_6656K86_Ultra-Thin Ball Bearing x 28
P_G_R_FR_FMU_SH x 28
P_G_R_FR_FMU_SF x 28
PE_G_R_FR_FMU_TFS x 112
PE_G_R_FR_FMU_SP x 112
P_G_R_FR_SH
PE_G_R_FR_98689A114
P_G_R_FR_SL
P_G_R_FR_MM x 2
P_G_R_MP
