S2A-Lab/CAD-Binder-Jetting-3D-Printer/X Axis/Rail/A_XA_R.SLDASM

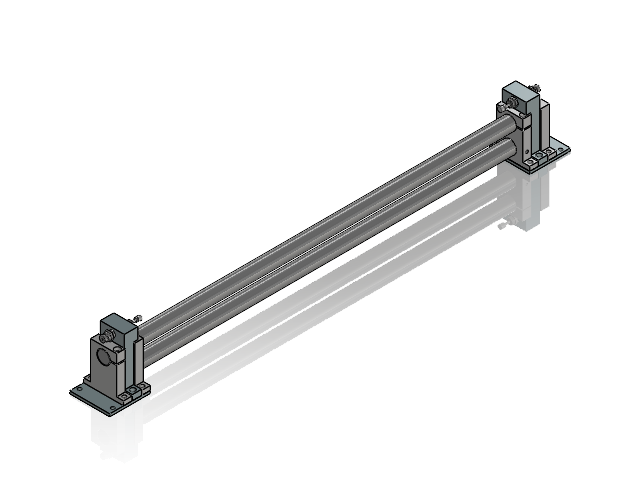
[picture p53: CAD file, 2025-05-02]
X Axis/Rail/A_XA_R.SLDASM
[part, external] MAKC1210Mb x 2
[part, external] MAKC1210Ar x 2
[part, external] M12x1_0414N2 x 4
PE_XA_R_P_SHWTM25_60_b_mod x 2
PE_XA_R_P_BF_004_Bumper_Block x 2
PE_XA_R_P_SHWTM25_60_b x 2
PE_XA_R_P_BF_012_Spacer x 2
PE_XA_R_SFJ25_810
PE_XA_R_SFU25_742
