S2A-Lab/CAD-Binder-Jetting-3D-Printer/Gantry/Hopper/A_G_H.SLDASM

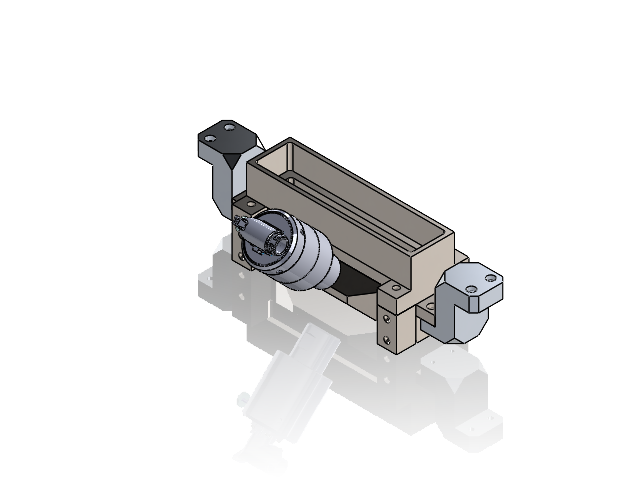
[picture p54: CAD file, 2025-05-02]
Gantry/Hopper/A_G_H.SLDASM
P_G_H_SM
P_G_H_SC
P_G_H_SMA x 4
PE_G_H_SK3510 Hummel 90
P_G_H_HADP
P_G_H_MT x 2
