S2A-Lab/CAD-Binder-Jetting-3D-Printer/Gantry/Recoating System/Fine Roller/A_G_R_FR.SLDASM

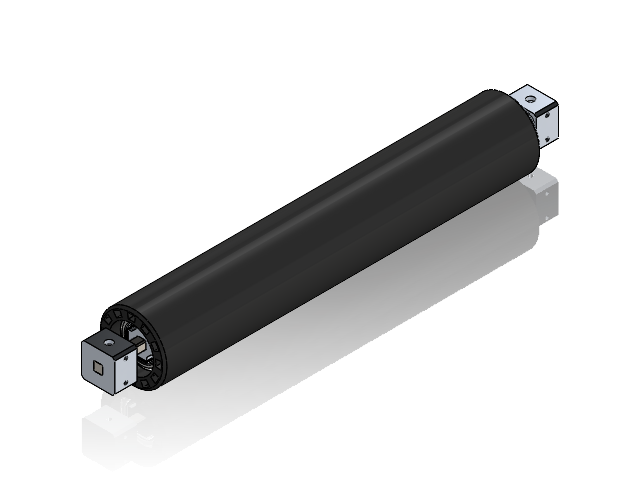
[picture p55: CAD file, 2025-05-02]
Gantry/Recoating System/Fine Roller/A_G_R_FR.SLDASM
PE_G_R_FR_FMU_6656K86_Ultra-Thin Ball Bearing x 28
P_G_R_FR_FMU_SH x 28
P_G_R_FR_FMU_SF x 28
PE_G_R_FR_FMU_TFS x 112
PE_G_R_FR_FMU_SP x 112
P_G_R_FR_SH
PE_G_R_FR_98689A114
P_G_R_FR_SL
P_G_R_FR_MM x 2
