S2A-Lab/CAD-Binder-Jetting-3D-Printer/Z Axis/AE_ZA_PZS-90_B.SLDASM

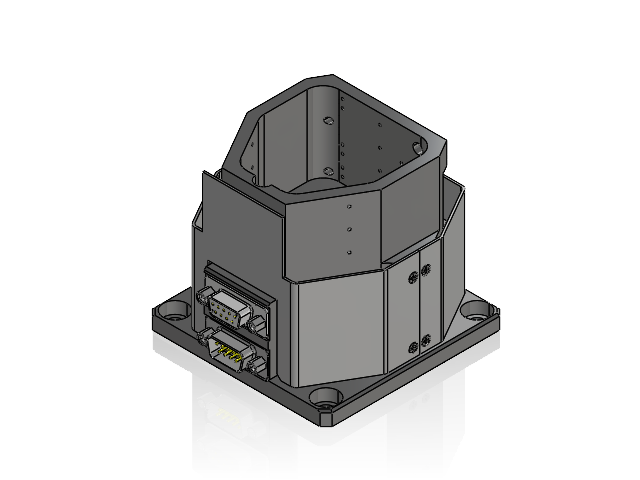
[picture p56: CAD file, 2025-05-02]
Z Axis/AE_ZA_PZS-90_B.SLDASM
PE_ZA_PZS-90_SCREW, MS-PFH, M-DIN_M2 x 0.4 x 0.4mm x 8
PE_ZA_PZS-90_B_SCREW, SHCS-S, M-DIN_M3 x 0.5 x 18mm x 4
PE_ZA_PZS-90_B_130008 D-sub Standoff x 4
PE_ZA_PZS-90_B_110007-A Connector D-sub Female SC
PE_ZA_PZS-90_B_110006-109 Connector D-sub Male SC
PE_ZA_PZS-90_B_INNER FRONT ENCLOSURE
PE_ZA_PZS-90_B_INNER BACK ENCLOSURE
PE_ZA_PZS-90_B_BASE PLATE
