S2A-Lab/CAD-Binder-Jetting-3D-Printer/Gantry/Recoating System/Fine Roller/A_G_R_FR_FMU.SLDASM

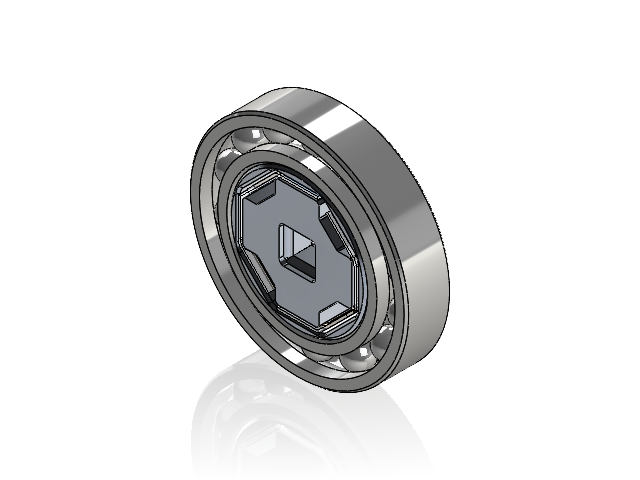
[picture p57: CAD file, 2025-05-02]
Gantry/Recoating System/Fine Roller/A_G_R_FR_FMU.SLDASM
PE_G_R_FR_FMU_6656K86_Ultra-Thin Ball Bearing
P_G_R_FR_FMU_SH
P_G_R_FR_FMU_SF
PE_G_R_FR_FMU_TFS x 4
PE_G_R_FR_FMU_SP x 4
