S2A-Lab/CAD-Binder-Jetting-3D-Printer/Z Axis/AE_ZA_PZS-90_C.SLDASM

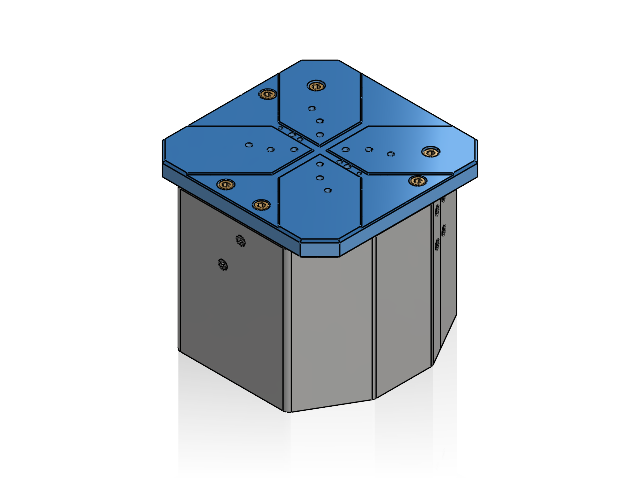
[picture p58: CAD file, 2025-05-02]
Z Axis/AE_ZA_PZS-90_C.SLDASM
PE_ZA_PZS-90_SCREW, MS-PFH, M-DIN_M2 x 0.4 x 0.4mm x 10
PE_ZA_PZS-90_C_OUTER BACK ENCLOSURE.STEP
PE_ZA_PZS-90_C_OUTER FRONT ENCLOSURE
PE_ZA_PZS-90_C_SCREW, SHCS-S, M-DIN_M3 x 0.5 x 08mm x 6
PE_ZA_PZS-90_C_BEARING MOUNT x 3
PE_ZA_PZS-90_C_COVER
