S2A-Lab/CAD-Binder-Jetting-3D-Printer/Gantry/Print Head Motion System/A_G_PHM.SLDASM

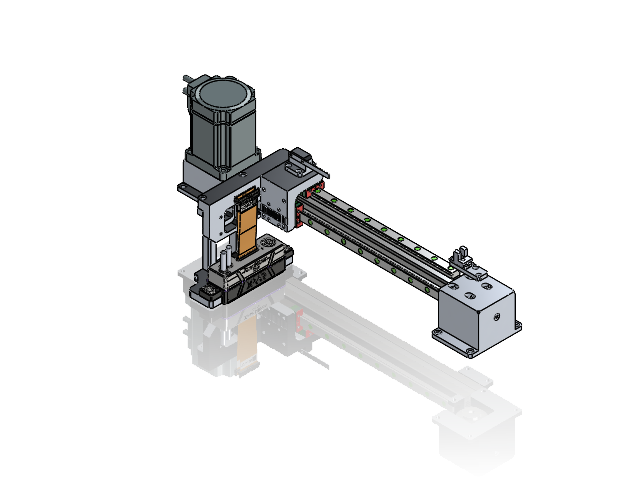
[picture p59: CAD file, 2025-05-02]
Gantry/Print Head Motion System/A_G_PHM.SLDASM
PE_A_G_PHM_NX620A
P_G_PHM_MB
PE_A_G_PHM_GPA48GT2090-B-H14_b
PE_G_PHM_XP100600xx - Xaar Nitrox Printhead 3D Model - Rev E (STEP)
PE_G_PHM_GFS6-3030-320
PE_G_PHM_MGN12C1R300Z0HM_EL_rail
PE_G_PHM_MGN12C1R265Z0HM_rail
PE_G_PHM_MGN12C1R300Z0HM_EL_carriage
PE_G_PHM_MGN12C1R265Z0HM_carriage
PE_G_PHM_AEB_A
PE_G_PHM_AEB_I
PE_G_PHM_GPA48GT2090-A-H14_b
PE_G_PHM_TB
PE_G_PHM_90358A157_Ultra-Low-Profile Socket Head Screw
PE_G_PHM_TBR
PE_G_PHM_C
PE_G_PHM_CABR
PE_G_PHM_CABL
PE_G_PHM_PHB
PE_G_PHM_HSBM
PE_G_PHM_EE_SX674
PE_G_PHM_HSM
PE_G_PHM_HSB
