S2A-Lab/CAD-Binder-Jetting-3D-Printer/Z Axis/A_ZA_G.SLDASM

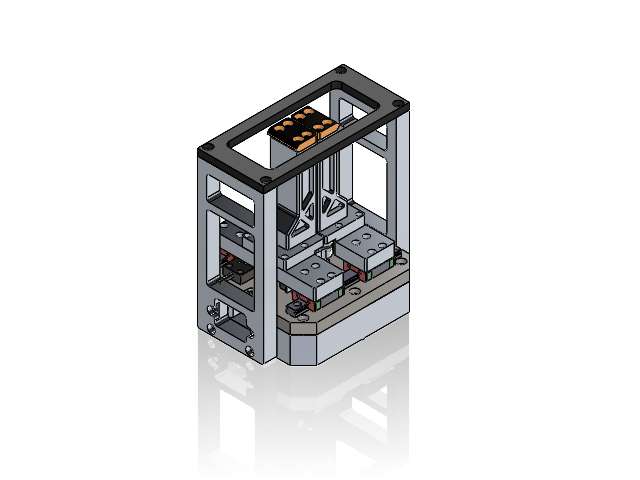
[picture p60: CAD file, 2025-05-02]
Z Axis/A_ZA_G.SLDASM
P_ZA_G_MCC
P_ZA_G_MCB
PE_ZA_G_SANMOTION-F2-SS2502-8040.step
PE_ZA_G_MGN7C2R80ZFHM_R x 2
PE_ZA_G_MGN7C2R80ZFHM_C x 4
P_ZA_G_C_F
PE_ZA_G_C_7806K53_Thrust Ball Bearing.step x 4
P_ZA_G_C_D
P_ZA_G_C_R x 2
PE_ZA_G_P_EE-SX954P-W x 2
P_ZA_G_P_B x 2
P_ZA_G_SB_P x 2
P_ZA_G_SB_C
P_ZA_G_J_BC x 2
P_ZA_G_J_B x 2
P_ZA_G_J_UC x 2
P_ZA_G_J_T x 2
