S2A-Lab/CAD-Binder-Jetting-3D-Printer/Z Axis/AE_ZA_PZS-90-11310.SLDASM

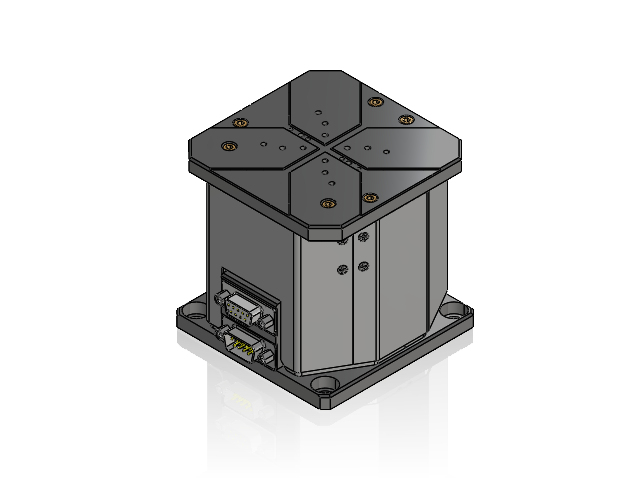
[picture p62: CAD file, 2025-05-02]
Z Axis/AE_ZA_PZS-90-11310.SLDASM
PE_ZA_PZS-90_SCREW, MS-PFH, M-DIN_M2 x 0.4 x 0.4mm x 18
PE_ZA_PZS-90_C_OUTER BACK ENCLOSURE.STEP
PE_ZA_PZS-90_C_OUTER FRONT ENCLOSURE
PE_ZA_PZS-90_C_SCREW, SHCS-S, M-DIN_M3 x 0.5 x 08mm x 6
PE_ZA_PZS-90_C_BEARING MOUNT x 3
PE_ZA_PZS-90_C_COVER
PE_ZA_PZS-90_B_SCREW, SHCS-S, M-DIN_M3 x 0.5 x 18mm x 4
PE_ZA_PZS-90_B_130008 D-sub Standoff x 4
PE_ZA_PZS-90_B_110007-A Connector D-sub Female SC
PE_ZA_PZS-90_B_110006-109 Connector D-sub Male SC
PE_ZA_PZS-90_B_INNER FRONT ENCLOSURE
PE_ZA_PZS-90_B_INNER BACK ENCLOSURE
PE_ZA_PZS-90_B_BASE PLATE
