S2A-Lab/CAD-Binder-Jetting-3D-Printer/Z Axis/AE_ZA_G_MGN7C2R80ZFHM.SLDASM

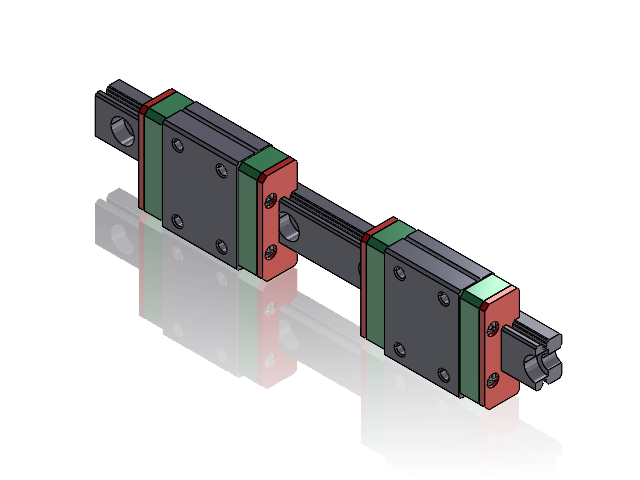
[picture p63: CAD file, 2025-05-02]
Z Axis/AE_ZA_G_MGN7C2R80ZFHM.SLDASM
PE_ZA_G_MGN7C2R80ZFHM_R
PE_ZA_G_MGN7C2R80ZFHM_C x 2
