S2A-Lab/CAD-Binder-Jetting-3D-Printer/Z Axis/A_ZA.SLDASM

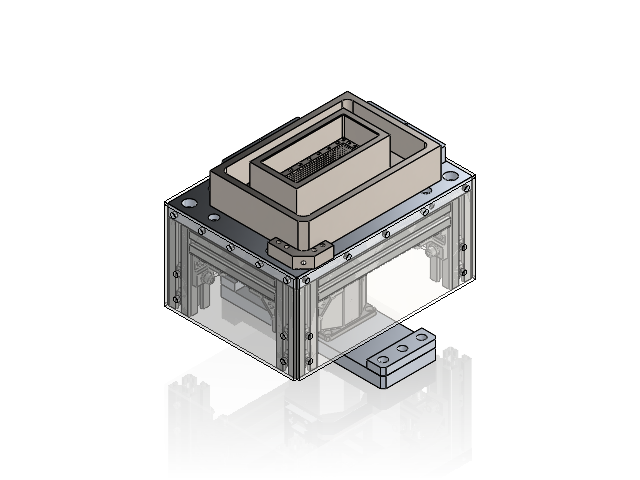
[picture p64: CAD file, 2025-05-02]
Z Axis/A_ZA.SLDASM
PE_ZA_PZS-90_SCREW, MS-PFH, M-DIN_M2 x 0.4 x 0.4mm x 18
PE_ZA_PZS-90_C_OUTER BACK ENCLOSURE.STEP
PE_ZA_PZS-90_C_OUTER FRONT ENCLOSURE
PE_ZA_PZS-90_C_SCREW, SHCS-S, M-DIN_M3 x 0.5 x 08mm x 6
PE_ZA_PZS-90_C_BEARING MOUNT x 3
PE_ZA_PZS-90_C_COVER
PE_ZA_PZS-90_B_SCREW, SHCS-S, M-DIN_M3 x 0.5 x 18mm x 4
PE_ZA_PZS-90_B_130008 D-sub Standoff x 4
PE_ZA_PZS-90_B_110007-A Connector D-sub Female SC
PE_ZA_PZS-90_B_110006-109 Connector D-sub Male SC
PE_ZA_PZS-90_B_INNER FRONT ENCLOSURE
PE_ZA_PZS-90_B_INNER BACK ENCLOSURE
PE_ZA_PZS-90_B_BASE PLATE
P_ZA_G_MCC
P_ZA_G_MCB
PE_ZA_G_SANMOTION-F2-SS2502-8040.step
PE_ZA_G_MGN7C2R80ZFHM_R x 2
PE_ZA_G_MGN7C2R80ZFHM_C x 4
P_ZA_G_C_F
PE_ZA_G_C_7806K53_Thrust Ball Bearing.step x 4
P_ZA_G_C_D
P_ZA_G_C_R x 2
PE_ZA_G_P_EE-SX954P-W x 2
P_ZA_G_P_B x 2
P_ZA_G_SB_P x 2
P_ZA_G_SB_C
P_ZA_G_J_BC x 2
P_ZA_G_J_B x 2
P_ZA_G_J_UC x 2
P_ZA_G_J_T x 2
P_ZA_J_PP_C
P_ZA_J_PP_N x 2
PE_ZA_J_PP_SS-QC4-B-2PM-SwagelokCompany
P_ZA_J_PP_CM
P_ZA_J_PP_MC
PE_ZA_J_PP_MIC5TL3
P_ZA_J_B
P_ZA_J_N x 2
P_ZA_JH_CP
P_ZA_JH_C x 2
P_ZA_JH_T
PE_ZA_JH_AEA_HFSP8-4040-155 x 2
PE_ZA_JH_AEA_HFSP8-4040-240 x 2
PE_ZA_JH_AEA_HFSP8-4040-140 x 4
PE_ZA_JH_AEA_SHNTP8-8 x 8
PE_ZA_JH_AEA_HBKTST8-SEC_b x 12
PE_ZA_JH_AEA_SPWF8 x 24
PE_ZA_JH_AEA_HCBST8_w1 x 24
PE_ZA_JH_AEA_HCBST8-24_Screw x 24
PE_ZA_JH_AEA_HNTT8-8 x 40
P_ZA_JH_FRP x 2
P_ZA_JH_SP x 2
P_ZA_MMPI x 2
P_ZA_MMPL
