S2A-Lab/CAD-Binder-Jetting-3D-Printer/Z Axis/A_ZA_JH.SLDASM

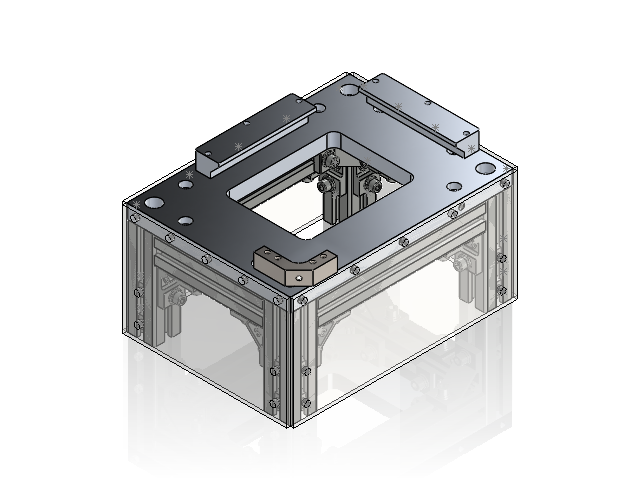
[picture p65: CAD file, 2025-05-02]
Z Axis/A_ZA_JH.SLDASM
P_ZA_JH_CP
P_ZA_JH_C x 2
P_ZA_JH_T
PE_ZA_JH_AEA_HFSP8-4040-155 x 2
PE_ZA_JH_AEA_HFSP8-4040-240 x 2
PE_ZA_JH_AEA_HFSP8-4040-140 x 4
PE_ZA_JH_AEA_SHNTP8-8 x 8
PE_ZA_JH_AEA_HBKTST8-SEC_b x 12
PE_ZA_JH_AEA_SPWF8 x 24
PE_ZA_JH_AEA_HCBST8_w1 x 24
PE_ZA_JH_AEA_HCBST8-24_Screw x 24
PE_ZA_JH_AEA_HNTT8-8 x 40
P_ZA_JH_FRP x 2
P_ZA_JH_SP x 2
