S2A-Lab/CAD-Binder-Jetting-3D-Printer/Z Axis/AE_ZA_JH_AEA_HBKTST8-SEC.SLDASM

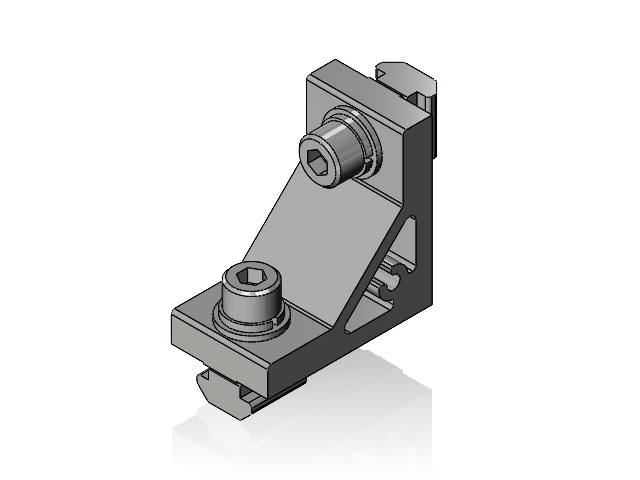
[picture p66: CAD file, 2025-05-02]
Z Axis/AE_ZA_JH_AEA_HBKTST8-SEC.SLDASM
PE_ZA_JH_AEA_HBKTST8-SEC_b
PE_ZA_JH_AEA_SPWF8 x 2
PE_ZA_JH_AEA_HCBST8_w1 x 2
PE_ZA_JH_AEA_HCBST8-24_Screw x 2
PE_ZA_JH_AEA_HNTT8-8 x 2
