S2A-Lab/CAD-Binder-Jetting-3D-Printer/Z Axis/A_ZA_J.SLDASM

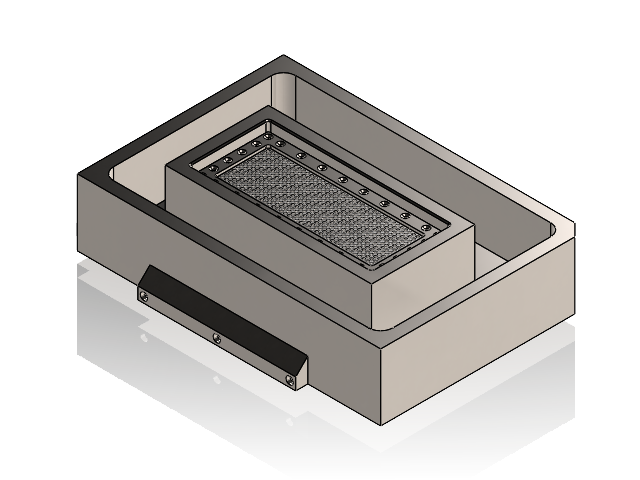
[picture p67: CAD file, 2025-05-02]
Z Axis/A_ZA_J.SLDASM
P_ZA_J_PP_C
P_ZA_J_PP_N x 2
PE_ZA_J_PP_SS-QC4-B-2PM-SwagelokCompany
P_ZA_J_PP_CM
P_ZA_J_PP_MC
PE_ZA_J_PP_MIC5TL3
P_ZA_J_B
P_ZA_J_N x 2
