S2A-Lab/CAD-Binder-Jetting-3D-Printer/(list of files, cad)

Other CAD files:
Cleaning Station/A_CS.SLDASM
Gantry/Recoating System/Fine Roller/pcb/Via Hole.sldasm
X Axis/Encoder Rail/PE_G_LA-9653-0188 TONIC ASSY.SLDPRT
Gantry/Recoating System/Fine Roller/pcb/Pad Fs1-0(919.842mil,490mil) on Top Layer.sldasm
Gantry/Recoating System/Fine Roller/pcb/Track (220mil,435mil)(232.718mil,435mil) on Top Layer.sldasm
Gantry/Recoating System/Fine Roller/pcb/Track (232.718mil,520mil)(262.718mil,490mil) on Top Layer.sldasm
Gantry/Recoating System/Fine Roller/pcb/Track (232.718mil,520mil)(262.718mil,490mil) on Top Layer-1.sldasm
Gantry/Recoating System/Fine Roller/pcb/Track (232.718mil,435mil)(242.718mil,445mil) on Top Layer.sldasm
Gantry/Recoating System/Fine Roller/pcb/Via Top Layer-1.sldasm
X Axis/Carriage/LA-9653-0188 TONIC ASSY.SLDPRT
Gantry/Recoating System/Fine Roller/pcb/Via (1235mil,435mil) from Top Layer to Bottom Layer.sldasm
Gantry/Recoating System/Fine Roller/pcb/GND.sldasm
Gantry/Recoating System/Fine Roller/pcb/Via Bottom Layer.sldasm
Gantry/Recoating System/Fine Roller/pcb/Track (1009.842mil,490mil)(1070mil,490mil) on Top Layer-1.sldasm
Gantry/Recoating System/Fine Roller/pcb/Pad Fs3-1(537.402mil,490mil) on Top Layer.sldasm
Gantry/Recoating System/Fine Roller/pcb/Track (1155mil,445mil)(1235mil,525mil) on Top Layer.sldasm
Gantry/Recoating System/Fine Roller/pcb/Track (220mil,435mil)(232.718mil,435mil) on Top Layer-1.sldasm
Gantry/Recoating System/Fine Roller/pcb/Pad Fs3-1(537.402mil,490mil) on Top Layer-1.sldasm
Gantry/Recoating System/Fine Roller/pcb/Track (919.842mil,490mil)(964.842mil,445mil) on Top Layer.sldasm
Gantry/Recoating System/Fine Roller/pcb/Via Hole-2.sldasm
Gantry/Recoating System/Fine Roller/pcb/Track (638.602mil,445mil)(683.602mil,490mil) on Top Layer-1.sldasm
Gantry/Recoating System/Fine Roller/pcb/Via Top Layer.sldasm
Gantry/Recoating System/Fine Roller/pcb/Track (232.718mil,435mil)(242.718mil,445mil) on Top Layer-1.sldasm
Gantry/Recoating System/Fine Roller/pcb/Pad Fs2-1(773.602mil,490mil) on Top Layer.sldasm
Gantry/Recoating System/Fine Roller/pcb/Track (964.842mil,445mil)(1155mil,445mil) on Top Layer.sldasm
Gantry/Recoating System/Fine Roller/pcb/PCB.sldasm
Gantry/Recoating System/Fine Roller/pcb/Track (537.402mil,490mil)(600mil,490mil) on Top Layer.sldasm
Gantry/Recoating System/Fine Roller/pcb/Pad Fs2-0(683.602mil,490mil) on Top Layer-1.sldasm
Gantry/Recoating System/Fine Roller/pcb/Track (262.718mil,490mil)(447.402mil,490mil) on Top Layer.sldasm
Gantry/Recoating System/Fine Roller/pcb/Track (242.718mil,445mil)(638.602mil,445mil) on Top Layer-1.sldasm
Gantry/Recoating System/Fine Roller/pcb/Via (835mil,490mil) from Top Layer to Bottom Layer.sldasm
Gantry/Recoating System/Fine Roller/pcb/Track (1070mil,490mil)(1180mil,490mil) on Bottom Layer-1.sldasm
Gantry/Recoating System/Fine Roller/pcb/Track (1180mil,490mil)(1235mil,435mil) on Bottom Layer.sldasm
Gantry/Recoating System/Fine Roller/pcb/Track (220mil,520mil)(232.718mil,520mil) on Top Layer.sldasm
Gantry/Recoating System/Fine Roller/pcb/Pad Fs1-1(1009.842mil,490mil) on Top Layer.sldasm
Gantry/Recoating System/Fine Roller/pcb/Track (262.718mil,490mil)(447.402mil,490mil) on Top Layer-1.sldasm
Gantry/Recoating System/Fine Roller/pcb/Track (919.842mil,490mil)(964.842mil,445mil) on Top Layer-1.sldasm
Gantry/Recoating System/Fine Roller/pcb/Pad Fs1-1(1009.842mil,490mil) on Top Layer-1.sldasm
Gantry/Recoating System/Fine Roller/pcb/Track (537.402mil,490mil)(600mil,490mil) on Top Layer-1.sldasm
Gantry/Recoating System/Fine Roller/pcb/Pad Fs3-0(447.402mil,490mil) on Top Layer-1.sldasm
Gantry/Recoating System/Fine Roller/pcb/Track (220mil,520mil)(232.718mil,520mil) on Top Layer-1.sldasm
Gantry/Recoating System/Fine Roller/pcb/Track (600mil,490mil)(835mil,490mil) on Bottom Layer.sldasm
Gantry/Recoating System/Fine Roller/pcb/Track (1070mil,490mil)(1180mil,490mil) on Bottom Layer.sldasm
Gantry/Recoating System/Fine Roller/pcb/Via (79.252mil,478.071mil) from Top Layer to Bottom Layer.sldasm
Gantry/Recoating System/Fine Roller/pcb/Track (638.602mil,445mil)(683.602mil,490mil) on Top Layer.sldasm
Gantry/Recoating System/Fine Roller/pcb/Via (1377.953mil,478.071mil) from Top Layer to Bottom Layer.sldasm
Gantry/Recoating System/Fine Roller/pcb/Track (242.718mil,445mil)(638.602mil,445mil) on Top Layer.sldasm
Gantry/Recoating System/Fine Roller/pcb/FS3.sldasm
Gantry/Recoating System/Fine Roller/pcb/Via (220mil,520mil) from Top Layer to Bottom Layer.sldasm
Gantry/Recoating System/Fine Roller/pcb/FS1.sldasm
Gantry/Recoating System/Fine Roller/pcb/Via Bottom Layer-1.sldasm
Gantry/Recoating System/Fine Roller/pcb/Via (1070mil,490mil) from Top Layer to Bottom Layer.sldasm
Gantry/Recoating System/Fine Roller/pcb/Track (1155mil,445mil)(1235mil,525mil) on Top Layer-1.sldasm
Gantry/Recoating System/Fine Roller/pcb/Track (773.602mil,490mil)(835mil,490mil) on Top Layer.sldasm
Gantry/Recoating System/Fine Roller/pcb/Pad Fs3-0(447.402mil,490mil) on Top Layer.sldasm
Gantry/Recoating System/Fine Roller/pcb/Track (600mil,490mil)(835mil,490mil) on Bottom Layer-1.sldasm
Gantry/Recoating System/Fine Roller/pcb/Via Hole-1.sldasm
Gantry/Recoating System/Fine Roller/pcb/Via (220mil,435mil) from Top Layer to Bottom Layer.sldasm
Gantry/Recoating System/Fine Roller/pcb/Track (773.602mil,490mil)(835mil,490mil) on Top Layer-1.sldasm
Gantry/Recoating System/Fine Roller/pcb/FS2.sldasm
Gantry/Recoating System/Fine Roller/pcb/Track (1180mil,490mil)(1235mil,435mil) on Bottom Layer-1.sldasm
Gantry/Recoating System/Fine Roller/pcb/Track (835mil,490mil)(1070mil,490mil) on Bottom Layer.sldasm
Gantry/Recoating System/Fine Roller/pcb/Track (1009.842mil,490mil)(1070mil,490mil) on Top Layer.sldasm
Gantry/Recoating System/Fine Roller/pcb/Pad Fs1-0(919.842mil,490mil) on Top Layer-1.sldasm
Gantry/Recoating System/Fine Roller/pcb/NoNet.sldasm
Gantry/Recoating System/Fine Roller/pcb/Pad Fs2-0(683.602mil,490mil) on Top Layer.sldasm
Gantry/Recoating System/Fine Roller/pcb/Track (835mil,490mil)(1070mil,490mil) on Bottom Layer-1.sldasm
Gantry/Recoating System/Fine Roller/pcb/Via (1235mil,525mil) from Top Layer to Bottom Layer.sldasm
Gantry/Recoating System/Fine Roller/pcb/Pad Fs2-1(773.602mil,490mil) on Top Layer-1.sldasm
Gantry/Recoating System/Fine Roller/pcb/Via (600mil,490mil) from Top Layer to Bottom Layer.sldasm
Gantry/Recoating System/Fine Roller/pcb/Track (964.842mil,445mil)(1155mil,445mil) on Top Layer-1.sldasm
Z Axis/PE_ZA_PZS-90_C_BEARING MOUNT.SLDPRT
X Axis/Carriage/PE_XA_C_S8025P02.SLDPRT
X Axis/Encoder Rail/PE_XA_ER_BF003_scale_block.SLDPRT
X Axis/Carriage/PE_XA_C_air_bushing_ID_25mm_solid_model_new_way_S302502_en.SLDPRT
X Axis/Rail/[part, external] M12x1_0414N2.SLDPRT
Z Axis/PE_ZA_JH_AEA_HNTT8-8.sldprt
Gantry/Print Head Motion System/PE_A_G_PHM_GPA48GT2090-B-H14_b.sldprt
Gantry/Recoating System/Fine Roller/pcb/Via Top Layer-Part-1-1.sldprt
X Axis/Carriage/PE_XA_C_WT_006_Spacer.SLDPRT
X Axis/Rail/PE_XA_R_P_SHWTM25_60_b.SLDPRT
Gantry/Recoating System/Fine Roller/pcb/Track (835mil,490mil)(1070mil,490mil) on Bottom Layer-Part-1.sldprt
X Axis/Carriage/PE_XA_C_MJELLS4_M5_B.SLDPRT
Gantry/Hopper/P_G_H_SMA.SLDPRT
Gantry/Print Head Motion System/PE_A_G_PHM_NX620A.SLDPRT
Gantry/Print Head Motion System/PE_G_PHM_90358A157_Ultra-Low-Profile Socket Head Screw.SLDPRT
Gantry/Print Head Motion System/PE_G_PHM_AEB_I.SLDPRT
Gantry/Print Head Motion System/PE_G_PHM_C.SLDPRT
Gantry/Print Head Motion System/PE_G_PHM_CABL.SLDPRT
Gantry/Print Head Motion System/PE_G_PHM_CABR.SLDPRT
Gantry/Print Head Motion System/PE_G_PHM_EE_SX674.SLDPRT
Gantry/Print Head Motion System/PE_G_PHM_GFS6-3030-320.SLDPRT
Gantry/Print Head Motion System/PE_G_PHM_GPA48GT2090-A-H14_b.sldprt
Gantry/Print Head Motion System/PE_G_PHM_HSBM.SLDPRT
Gantry/Print Head Motion System/PE_G_PHM_HSM.SLDPRT
Gantry/Print Head Motion System/PE_G_PHM_MGN12C1R265Z0HM_rail.SLDPRT
Gantry/Print Head Motion System/PE_G_PHM_MGN12C1R300Z0HM_EL_carriage.SLDPRT
Gantry/Print Head Motion System/PE_G_PHM_PHB.SLDPRT
Gantry/Print Head Motion System/PE_G_PHM_TB.SLDPRT
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
