S2A-Lab/CAD-Binder-Jetting-3D-Printer/(list of files, drawings)

Other design files:
Gantry/Recoating System/Fine Roller/pcb.force_sensor/fpc_force_sensor/force_sensor_lib.SchLib
Gantry/Recoating System/Fine Roller/pcb.force_sensor/fpc_force_sensor/fpc_1.SchDoc
Gantry/Recoating System/Fine Roller/pcb.force_sensor/fpc_force_sensor/fpc_force_sensor.PrjPcb
Gantry/Recoating System/Fine Roller/pcb.force_sensor/fpc_force_sensor/PCB1.PcbDoc
Gantry/Recoating System/Fine Roller/pcb.force_sensor/fpc_force_sensor/sensor_lib.PcbLib
